Alexanderallenbrown/MotionBase/figures/MotionBase2.jpg

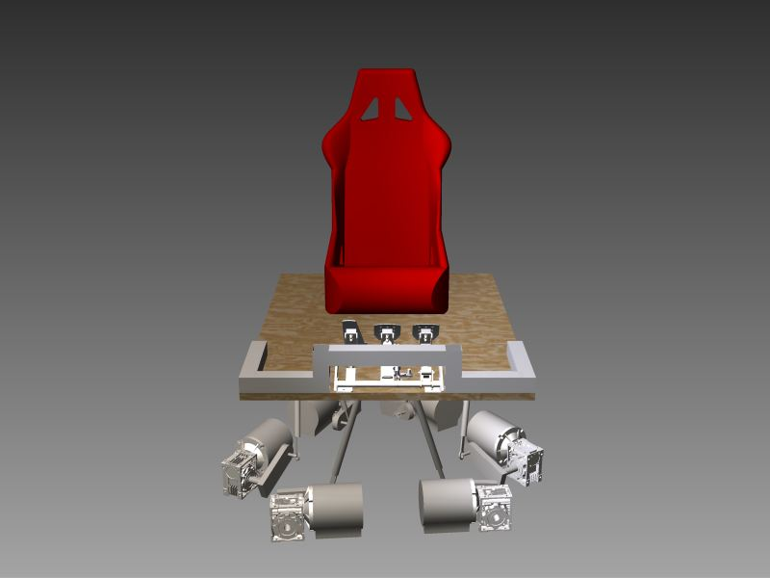
figures/MotionBase2.jpg
