Alexanderallenbrown/MotionBase/figures/20160426_115752.jpg

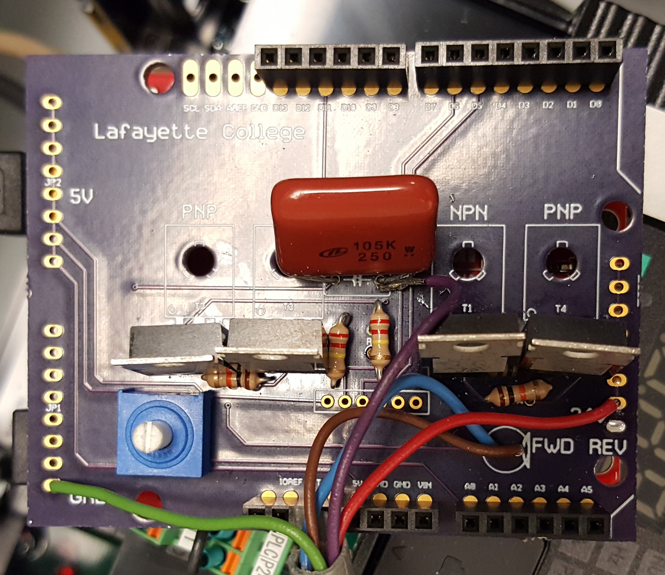
figures/20160426_115752.jpg
