Alexanderallenbrown/MotionBase/README.md

# MotionBase
An open-source motion platform for driving simulation

**For the wiki page documenting this project, please see the Wiki link above**
