Alexanderallenbrown/MotionBase/Board_Pictures/IMG_4478.JPG

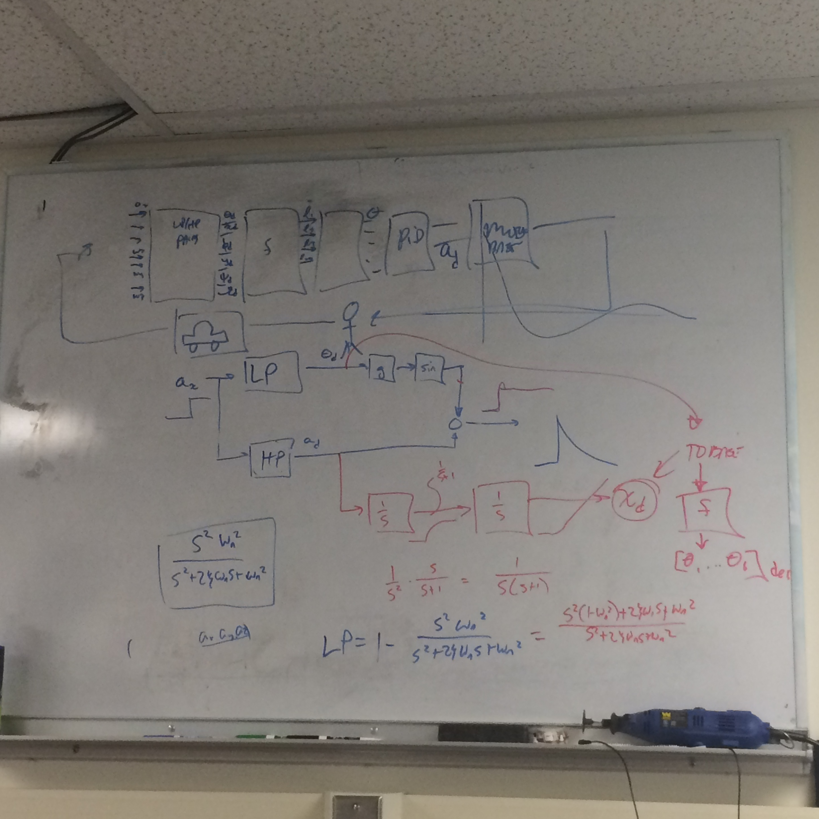
Board_Pictures/IMG_4478.JPG
