Alexanderallenbrown/MotionBase/Board_Pictures/IMG_4479.JPG

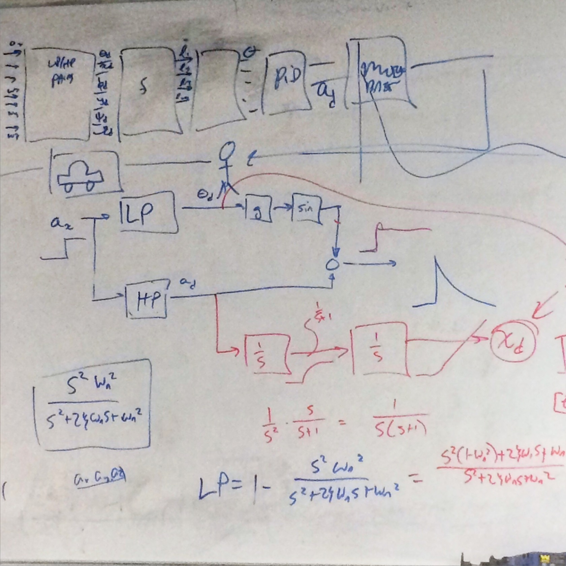
Board_Pictures/IMG_4479.JPG
