Alexanderallenbrown/MotionBase/Board_Pictures/IMG_4487.JPG

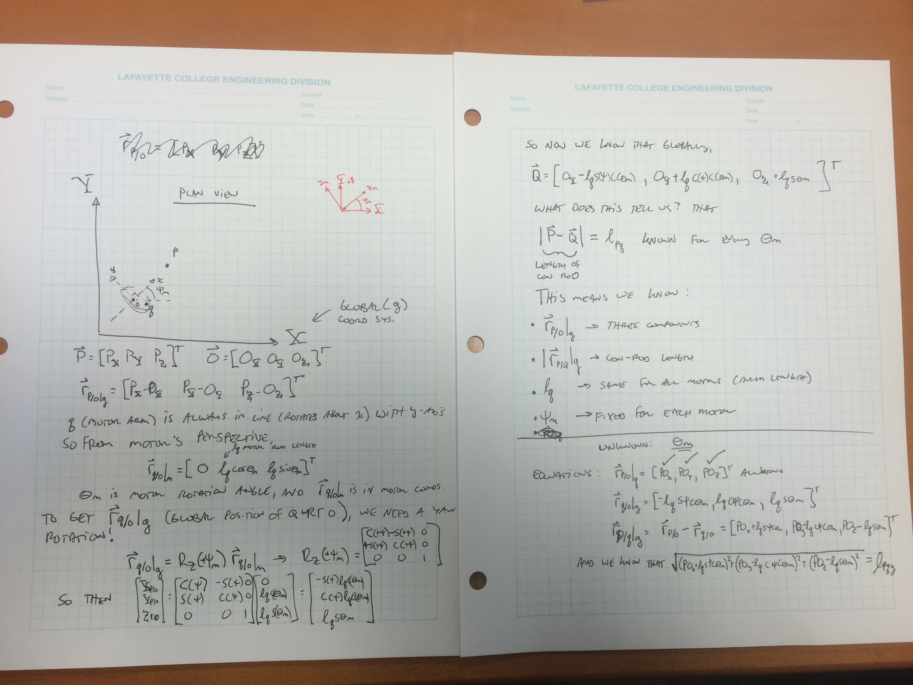
Board_Pictures/IMG_4487.JPG
