Alexanderallenbrown/MotionBase/Board_Pictures/IMG_4494.JPG

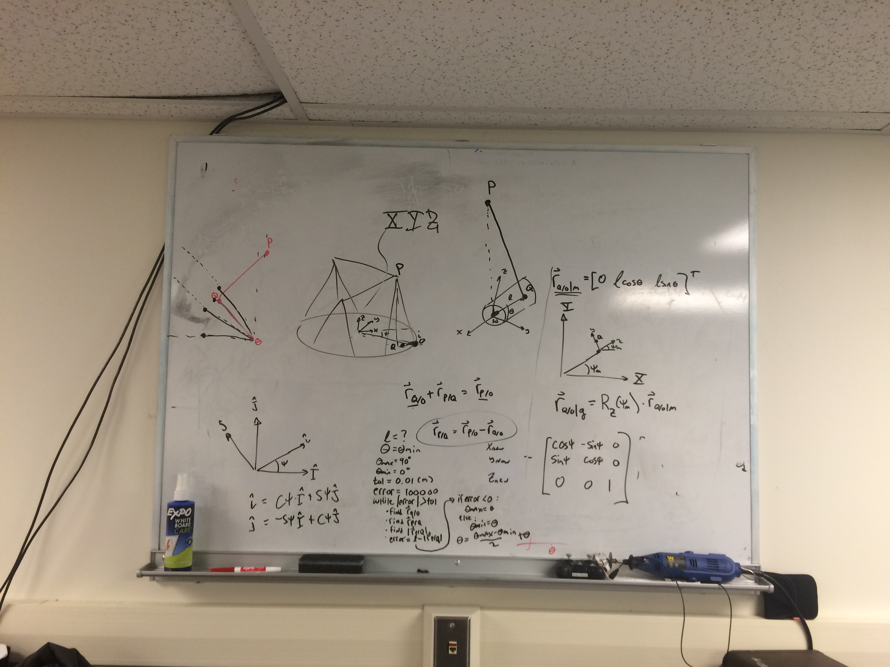
Board_Pictures/IMG_4494.JPG
