Alexanderallenbrown/MotionBase/Board_Pictures/IMG_4495.JPG

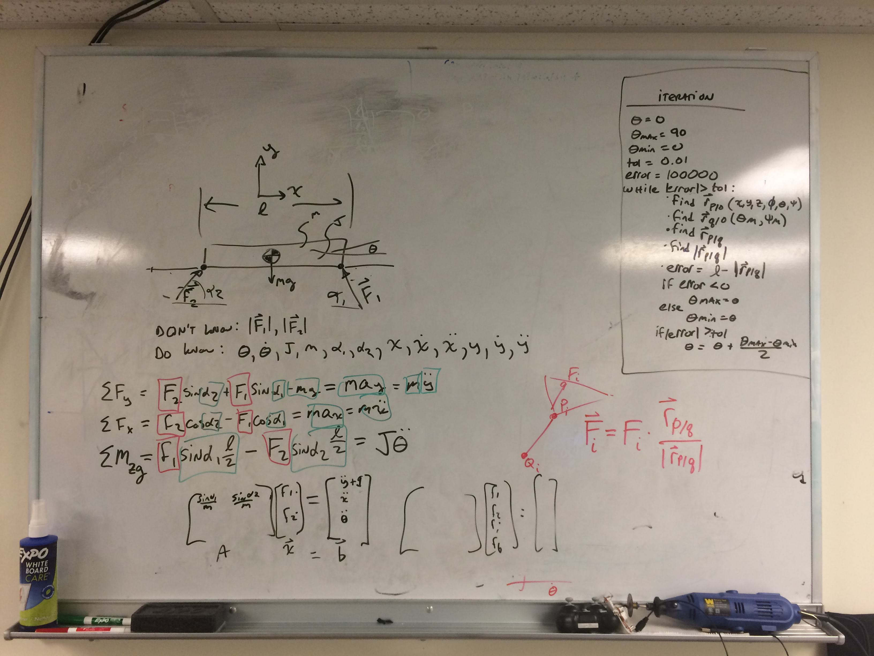
Board_Pictures/IMG_4495.JPG
