Alexanderallenbrown/MotionBase/figures/2525_1_.jpg

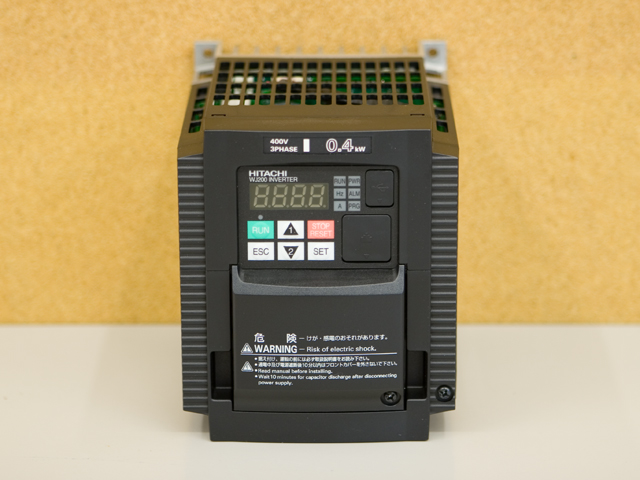
figures/2525_1_.jpg
