Alexanderallenbrown/MotionBase/figures/filtered t-w graph.png

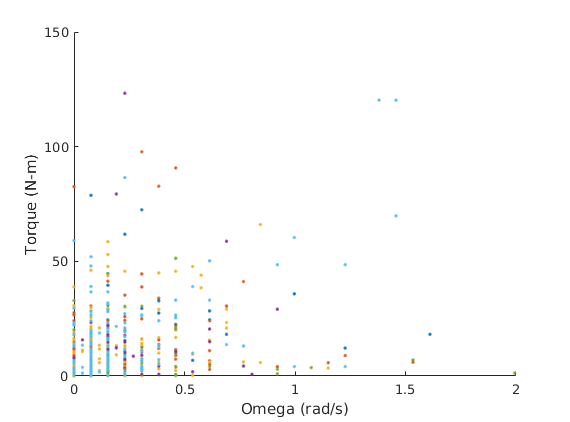
figures/filtered t-w graph.png
