Alexanderallenbrown/MotionBase/figures/helical_gear.jpg

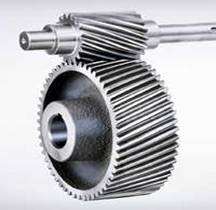
figures/helical_gear.jpg
