Alexanderallenbrown/MotionBase/figures/IMG_5075.jpg

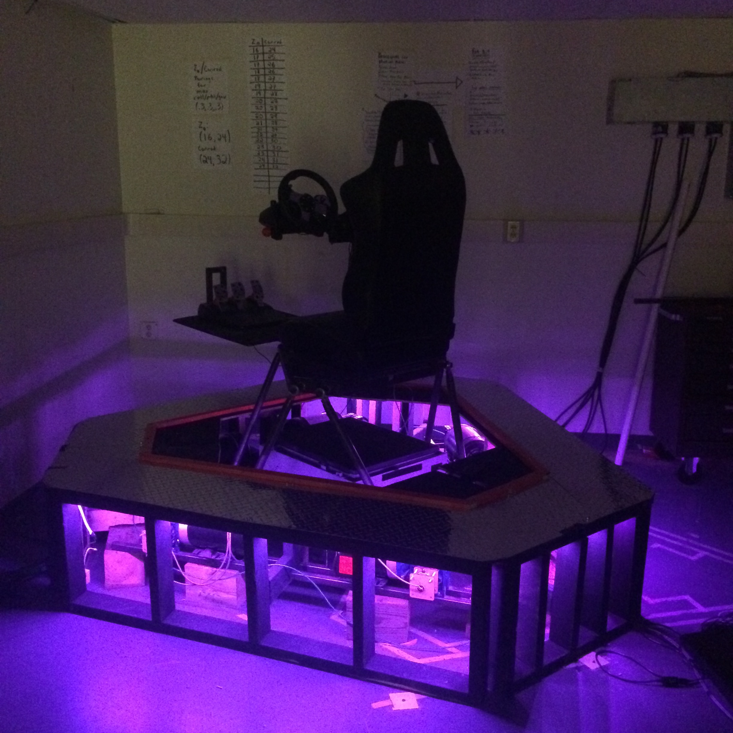
figures/IMG_5075.jpg
