Alexanderallenbrown/MotionBase/figures/m_tprs56cmtrs.jpg

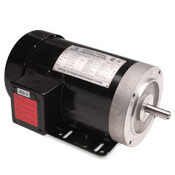
figures/m_tprs56cmtrs.jpg
