Alexanderallenbrown/MotionBase/figures/m_wga50m080h1.jpg

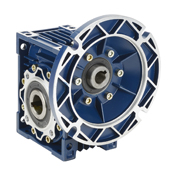
figures/m_wga50m080h1.jpg
