Alexanderallenbrown/MotionBase/figures/Mechatronics control diagram_v3.png

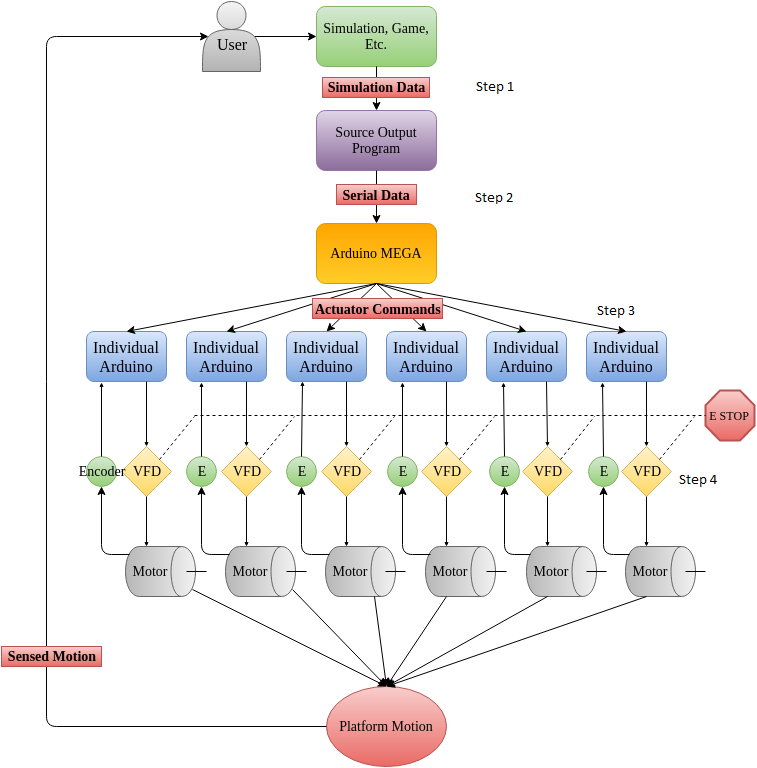
figures/Mechatronics control diagram_v3.png
