Alexanderallenbrown/MotionBase/figures/MotionBase1.jpg

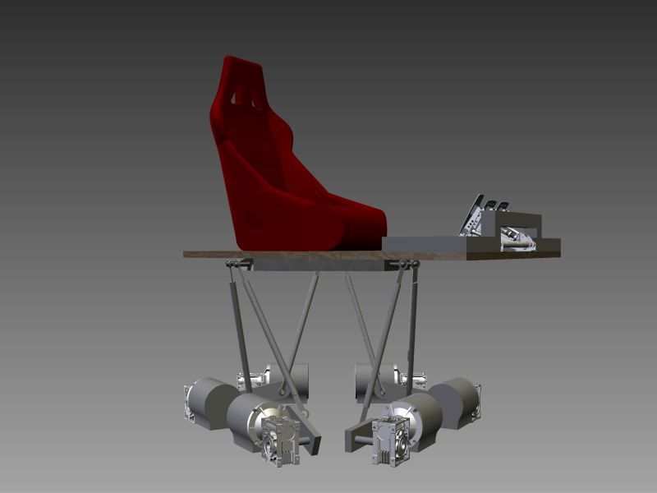
figures/MotionBase1.jpg
