Alexanderallenbrown/MotionBase/figures/MotionBaseNew2.jpg

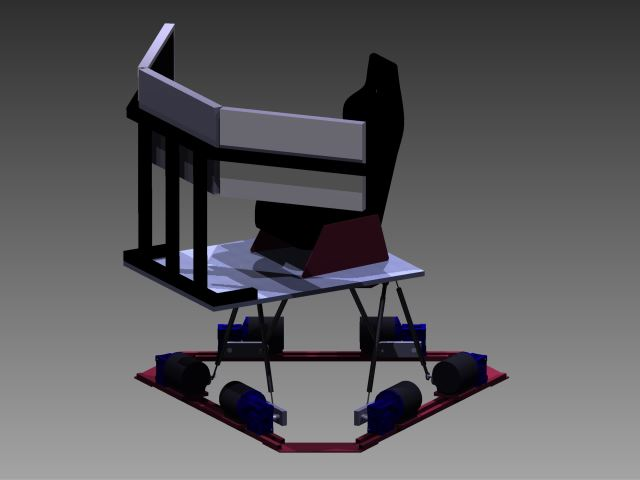
figures/MotionBaseNew2.jpg
