Alexanderallenbrown/MotionBase/figures/MotionBaseNew.jpg

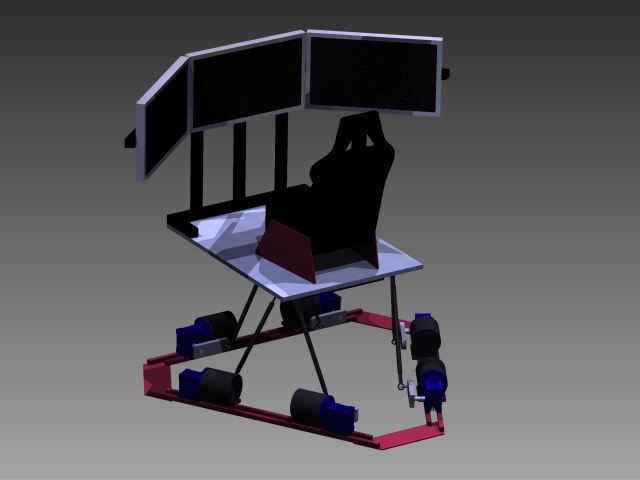
figures/MotionBaseNew.jpg
