Alexanderallenbrown/MotionBase/figures/motor bounds.png

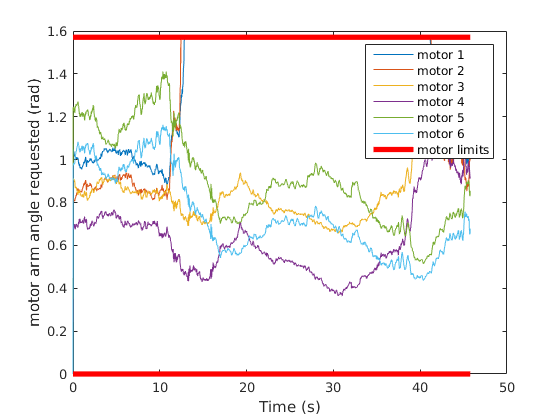
figures/motor bounds.png
