Alexanderallenbrown/MotionBase/figures/motor_angles.png

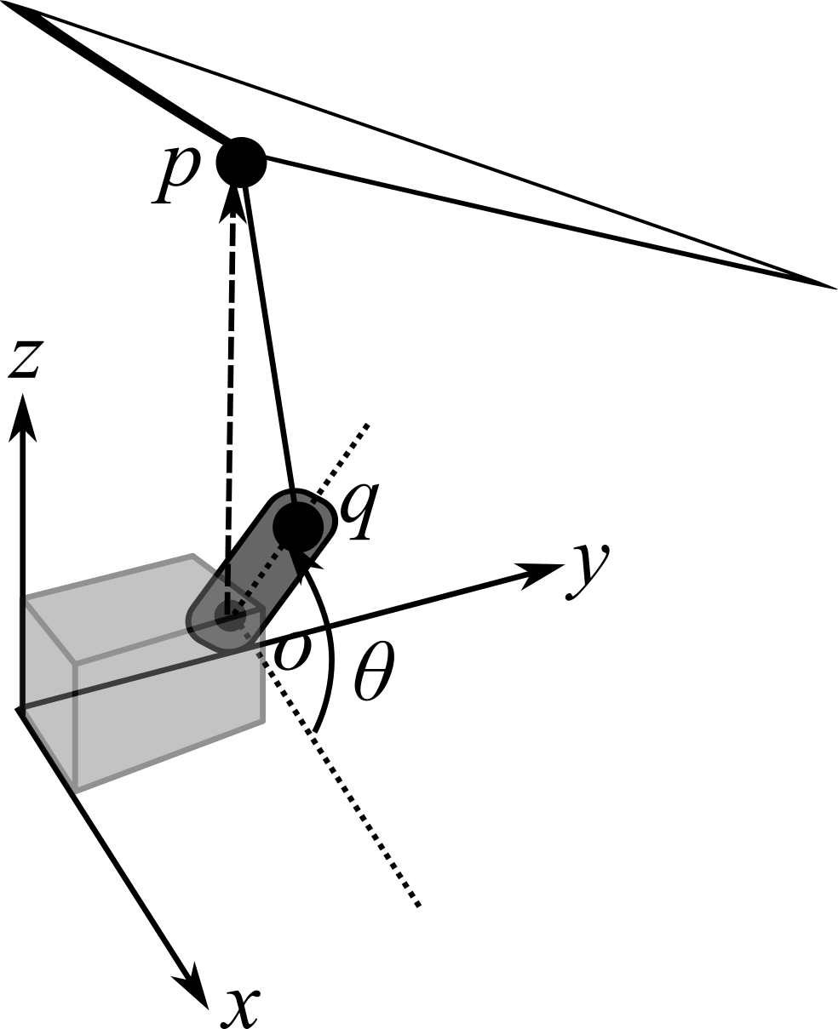
figures/motor_angles.png
