Alexanderallenbrown/MotionBase/figures/pwm_wave.png

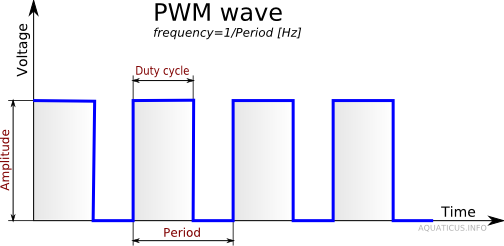
figures/pwm_wave.png
