Alexanderallenbrown/MotionBase/figures/Torque-Omega_Curve.jpg

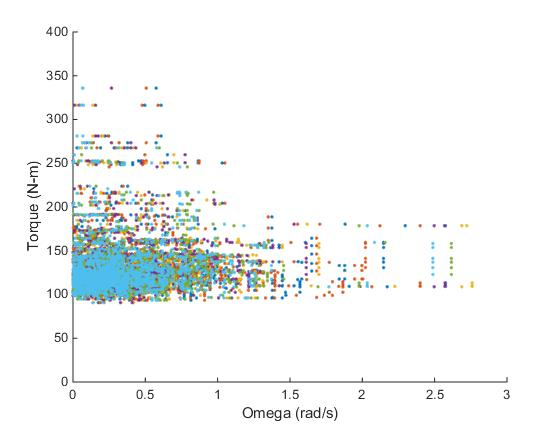
figures/Torque-Omega_Curve.jpg
