Alexanderallenbrown/MotionBase/figures/x_angley.jpg

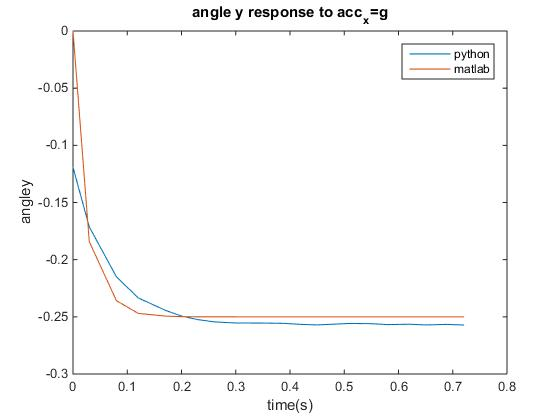
figures/x_angley.jpg
