Alexanderallenbrown/MotionBase/figures/x_xacc.jpg

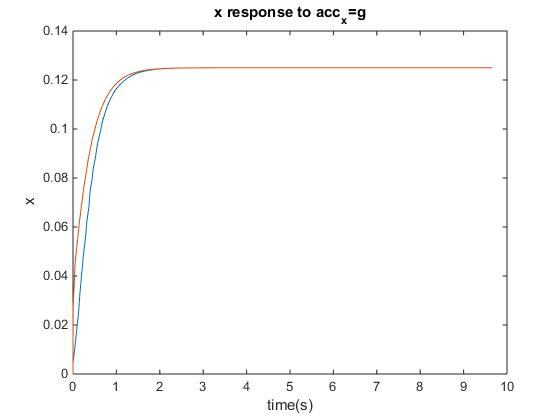
figures/x_xacc.jpg
