Alexanderallenbrown/MotionBase/figures/yaw_response.jpg

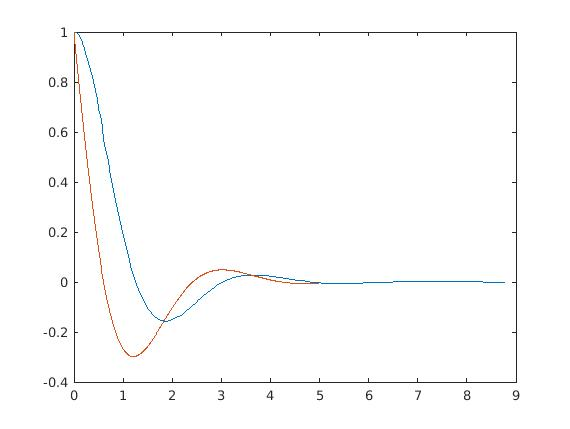
figures/yaw_response.jpg
