Alexanderallenbrown/MotionBase/figures/z_zacc.jpg

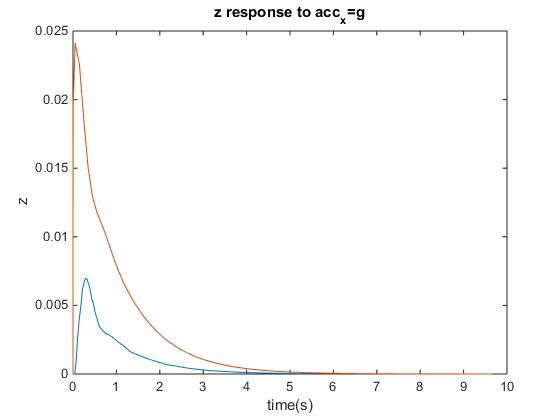
figures/z_zacc.jpg
