Alexanderallenbrown/MotionBase/mini_platform/board/board_v0_1.png

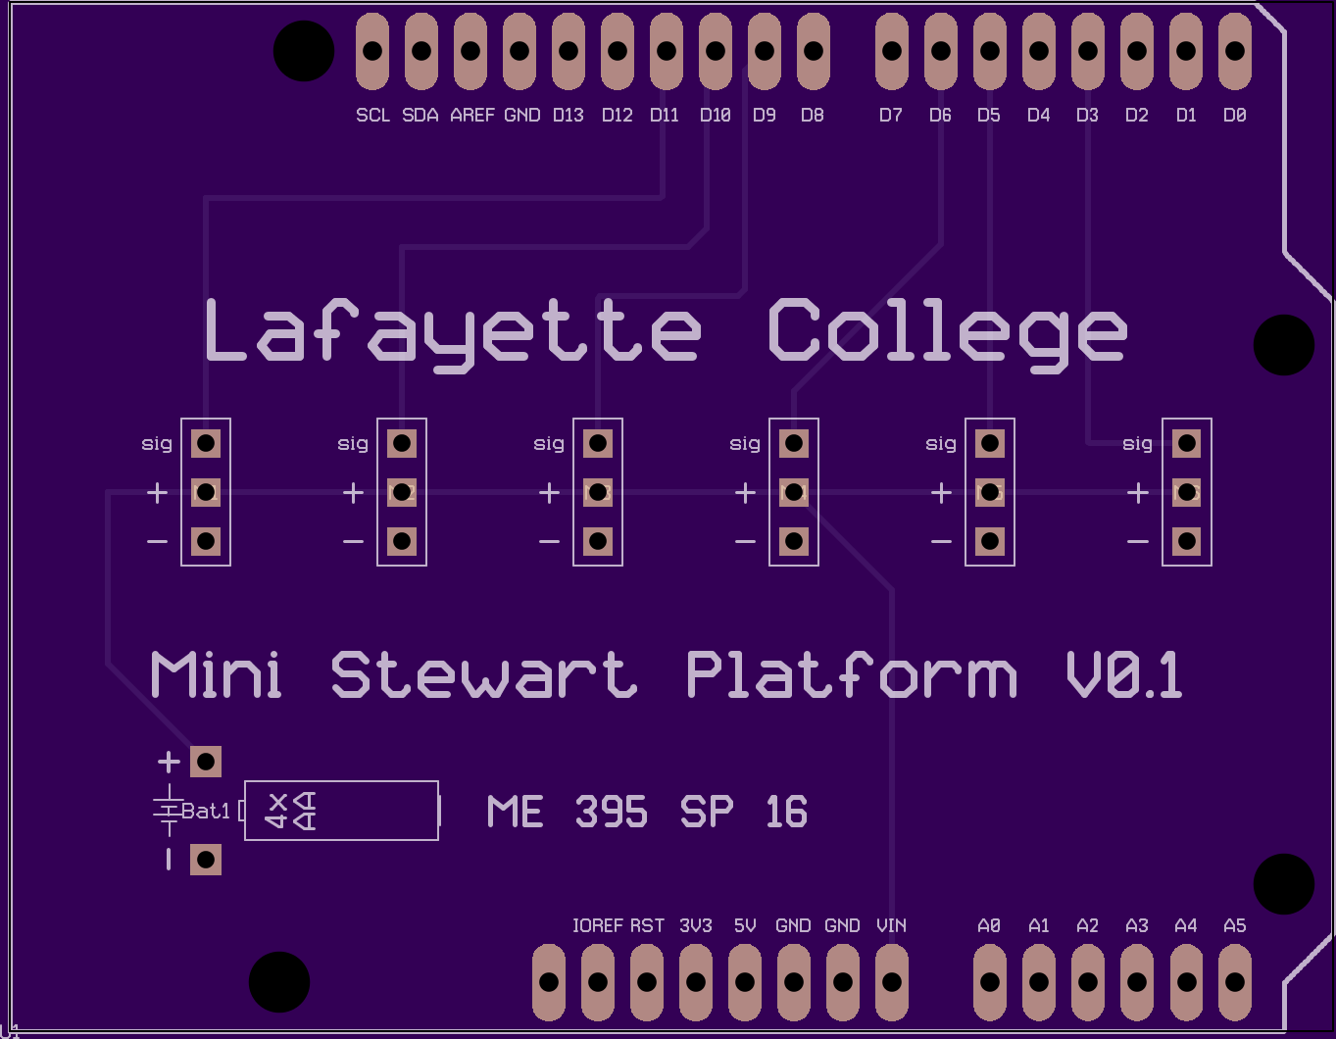
mini_platform/board/board_v0_1.png
