Alexanderallenbrown/MotionBase/python/controller_diagram.png

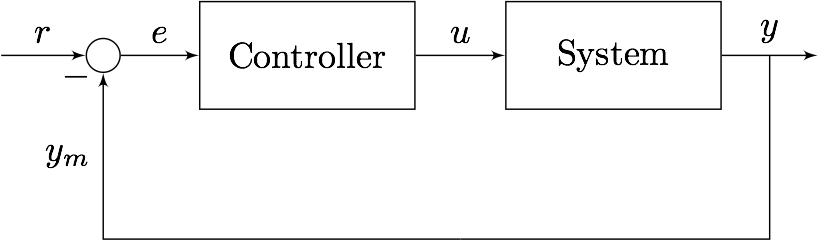
python/controller_diagram.png
