Alexanderallenbrown/MotionBase/python/lowpass_highpass-2.png

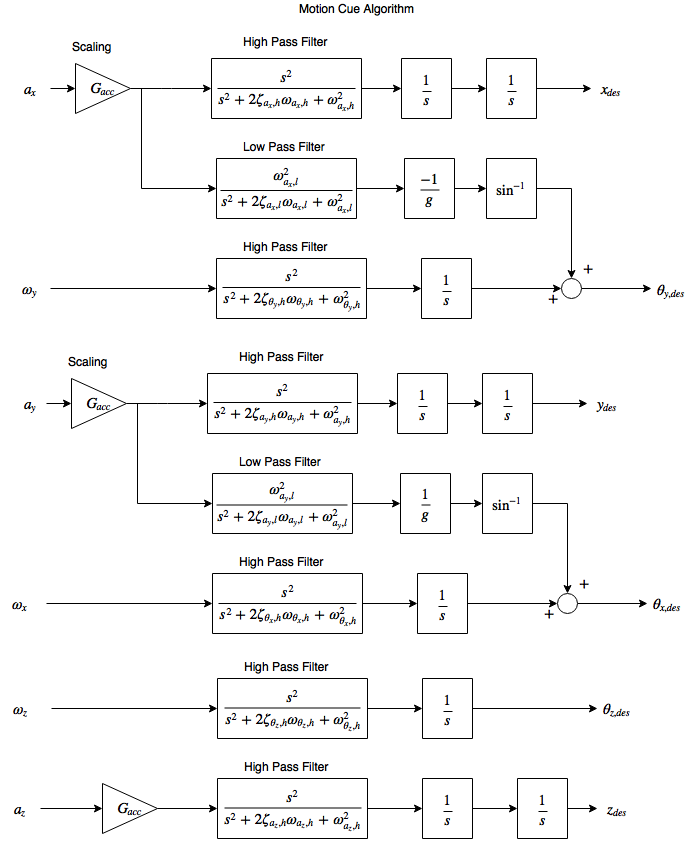
python/lowpass_highpass-2.png
