Alexanderallenbrown/MotionBase/CAD/MotionBaseCAD/Imported Components/TMDF 180L/TMDF 180L.htm

Autodesk Inventor Translation Report | Monday, February 22, 2016 ( 10:29 AM)
Source File: | C:\Users\jonesdm\Desktop\motionbase\CAD\MotionBaseCAD\TMDF 180L.SLDPRT
Translator Type: | SolidWorks | Sending System: | SolidWorks 2014
Author: |  | Translation Time: | 00:00:01
Options
Import Type: | N/A
Entity Types to Import: | Solids, Surfaces, Wires
Import into Repair Environment: | Yes
Import Assembly as Single Part: | No
Create Surfaces As: | Single Composite Feature
Check Parts during Load: | No
Auto Stitch: | No
Enable Advanced Healing: | N/A
+/- | Name | Inventor File | Status
[ ] | TMDF 180L.ipt | C:\Users\jonesdm\Desktop\motionbase\CAD\MotionBaseCAD\Imported Components\TMDF 180L\TMDF 180L.ipt | Successful
