Alexanderallenbrown/MotionBase/CAD/MotionBaseCAD/Imported Components/WGA-50M-080-H1/WGA-50M-080-H1.htm

Autodesk Inventor Translation Report | Wednesday, February 24, 2016 ( 9:17 AM)
Source File: | C:\Users\jonesdm\Desktop\MotionBase\CAD\MotionBaseCAD\WGA-50M-080-H1.STEP
Translator Type: | STEP | Sending System: | SolidWorks 2014
Author: |  | Translation Time: | 00:00:00
Options
Import Type: | N/A
Entity Types to Import: | Solids, Surfaces, Wires, Points
Import into Repair Environment: | Yes
Import Assembly as Single Part: | No
Create Surfaces As: | Single Composite Feature
Check Parts during Load: | No
Auto Stitch: | No
Enable Advanced Healing: | N/A
+/- | Name | Inventor File | Status
[ ] | WGA-50M-080-H1.ipt | C:\Users\jonesdm\Desktop\MotionBase\CAD\MotionBaseCAD\Imported Components\WGA-50M-080-H1\WGA-50M-080-H1.ipt | Successful
