Alexanderallenbrown/MotionBase/CAD/MotionBaseCAD/Real Platform/Imported Components/BallJoint/BallJoint.htm

Autodesk Inventor Translation Report | Thursday, April 7, 2016 ( 3:04 PM)
Source File: | C:\Users\Mac\Desktop\MotionBase\CAD\MotionBaseCAD\Real Platform\BallJoint.STEP
Translator Type: | STEP | Sending System: | SolidWorks 2012
Author: | Admin | Translation Time: | 00:00:17
Options
Import Type: | N/A
Entity Types to Import: | Solids, Surfaces, Wires, Points
Import into Repair Environment: | Yes
Import Assembly as Single Part: | No
Create Surfaces As: | Single Composite Feature
Check Parts during Load: | No
Auto Stitch: | No
Enable Advanced Healing: | N/A
+/- | Name | Inventor File | Status
[+] [-] | BallJoint | C:\Users\Mac\Desktop\MotionBase\CAD\MotionBaseCAD\Real Platform\Imported Components\BallJoint\BallJoint.ipt | Warning
Severity | Entity Id | Message
Warning | 2278 | Some Surfaces have been simplified
