Alexanderallenbrown/MotionBase/CAD/MotionBaseCAD/Real Platform/Imported Components/ThreadedCaps/ThreadedCaps.htm

Autodesk Inventor Translation Report | Thursday, April 7, 2016 ( 3:02 PM)
Source File: | C:\Users\Mac\Desktop\MotionBase\CAD\MotionBaseCAD\Real Platform\ThreadedCaps.STEP
Translator Type: | STEP | Sending System: | SolidWorks 2010
Author: |  | Translation Time: | 00:00:38
Options
Import Type: | N/A
Entity Types to Import: | Solids, Surfaces, Wires, Points
Import into Repair Environment: | Yes
Import Assembly as Single Part: | No
Create Surfaces As: | Single Composite Feature
Check Parts during Load: | No
Auto Stitch: | No
Enable Advanced Healing: | N/A
+/- | Name | Inventor File | Status
[ ] | ThreadedCaps | C:\Users\Mac\Desktop\MotionBase\CAD\MotionBaseCAD\Real Platform\Imported Components\ThreadedCaps\ThreadedCaps.ipt | Successful
