Alexanderallenbrown/MotionBase/Bill of Materials/BaseTriangle.xlsx

Senior Design - PURCHASE REQUEST FORM
Project Name: |  | ME395
STUDENT Information
Name: |  | Mac Jones
Supervisor |  | Alex Brown
Contact E-Mail: |  | jonesdm@lafayette.edu
Account to Charge:
VENDOR Information
Date: | 2016-04-11 |  |  |  | Web/email address: | mcmaster.com
Vendor Name: |  | McMaster
Address:
City: |  |  |  | State: |  | Zip Code:
Phone:
Fax:
# | Qty | Unit | Part # | Description |  |  | Unit Price | Price
1 | 6 | PCS | 6527K364 (http://www.mcmaster.com/) | Low-Carbon Steel Square Tube 1" Wide, 1" High, .120" Wall Thickness, 6 ft. length |  |  | $24.14 | $144.84
2 | 1 | PCS | 6544K67 (http://www.mcmaster.com/) | Low-Carbon Steel Sheet 0.120" Thick, 24" x 24" |  |  | $61.54 | $61.54
3 | 1 | PKG | 97083A330 (http://www.mcmaster.com/) | Internally Threaded Anchor for Concrete Zinc-Plated Steel, 1/2"-13 Screw Size, 2" Length |  |  | $13.14 | $13.14
4 | 1 | PKG | 92865A720 (http://www.mcmaster.com/) | Medium-Strength Grade 5 Zinc-Plated Steel Cap Screw 1/2"-13 Fully Threaded, 2" Long |  |  | $7.85 | $7.85
5 | 1 | PCS | 8975K102 (http://www.mcmaster.com/) | Multipurpose 6061 Aluminum 1" Thick x 10" Width, 3ft. Length |  |  | $186.71 | $186.71
6 |  |  |  |  |  |  |  | $0.00
7 |  |  |  |  |  |  |  | $0.00
8 |  |  |  |  |  |  |  | $0.00
9 |  |  |  |  |  |  |  | $0.00
10 |  |  |  |  |  |  |  | $0.00
11 |  |  |  |  |  |  |  | $0.00
12 |  |  |  |  |  |  |  | $0.00
13 |  |  |  |  |  |  |  | $0.00
14 |  |  |  |  |  |  |  | $0.00
15 |  |  |  |  |  |  |  | $0.00
16 |  |  |  |  |  |  |  | $0.00
17 |  |  |  |  |  |  |  | $0.00
18 |  |  |  |  |  |  |  | $0.00
19 |  |  |  |  |  |  |  | $0.00
20 |  |  |  |  |  |  |  | $0.00
Total |  |  |  |  |  |  |  | $414.08
Advisor Signature:
 |  |  |  | Alexander Brown
Comments/Special Instructions:
