Alexanderallenbrown/MotionBase/Bill of Materials/Digikey.xlsx

Senior Design - PURCHASE REQUEST FORM
Project Name: |  | ME395
STUDENT Information
Name: |  | Mac Jones
Supervisor |  | Alex Brown
Contact E-Mail: |  | jonesdm@lafayette.edu
Account to Charge:
VENDOR Information
Date: | 2016-04-14 |  |  |  | Web/email address: | digikey.com
Vendor Name: |  | Digikey
Address:
City: |  |  |  | State: |  | Zip Code:
Phone:
Fax:
# | Qty | Unit | Part # | Description |  |  | Unit Price | Price
1 | 10 | PCS | BC33825TACT-ND (https://www.digikey.com/product-detail/en/fairchild-semiconductor/BC33825TA/BC33825TACT-ND/4213833) | TRANS NPN 25V 0.8A TO-92 |  |  | $0.20 | $1.96
2 | 10 | PCS | SS8550BBUFS-ND (https://www.digikey.com/product-detail/en/fairchild-semiconductor/SS8550BBU/SS8550BBUFS-ND/1047357) | TRANS PNP 25V 1.5A TO-92 |  |  | $0.20 | $1.96
3 | 10 | PCS | 445-8517-ND (https://www.digikey.com/product-detail/en/tdk-corporation/FK24X7R1H105K/445-8517-ND/2815447) | 1µF ±10% 50V X7R Ceramic Capacitor -55°C ~ 125°C Through Hole Radial 0.177" L x 0.098" W (4.50mm x 2.50mm) |  |  | $0.28 | $2.78
4 | 30 | PCS | CF14JT10K0CT-ND (https://www.digikey.com/product-detail/en/stackpole-electronics-inc/CF14JT10K0/CF14JT10K0CT-ND/1830374) | 10k Ohm ±5% 0.25W, 1/4W Surface Mount Resistor Carbon Film 0/ -500ppm/°C Axial |  |  | $0.04 | $1.20
5 | 10 | PCS | CF12JT220KCT-ND (https://www.digikey.com/product-detail/en/stackpole-electronics-inc/CF12JT220K/CF12JT220KCT-ND/1830532) | 220k Ohm ±5% 0.5W, 1/2W Surface Mount Resistor Carbon Film 0/ -850ppm/°C Axial |  |  | $0.07 | $0.72
6 | 6 | PCS | 3310Y-025-103L-ND (https://www.digikey.com/product-detail/en/bourns-inc/3310Y-025-103L/3310Y-025-103L-ND/2534071) | POT 10K OHM 1/4W PLASTIC LINEAR |  |  | $3.65 | $21.90
7 |  |  |  |  |  |  |  | $0.00
8 |  |  |  |  |  |  |  | $0.00
9 |  |  |  |  |  |  |  | $0.00
10 |  |  |  |  |  |  |  | $0.00
11 |  |  |  |  |  |  |  | $0.00
12 |  |  |  |  |  |  |  | $0.00
13 |  |  |  |  |  |  |  | $0.00
14 |  |  |  |  |  |  |  | $0.00
15 |  |  |  |  |  |  |  | $0.00
16 |  |  |  |  |  |  |  | $0.00
17 |  |  |  |  |  |  |  | $0.00
18 |  |  |  |  |  |  |  | $0.00
19 |  |  |  |  |  |  |  | $0.00
20 |  |  |  |  |  |  |  | $0.00
Total |  |  |  |  |  |  |  | $30.52
Advisor Signature:
 |  |  |  | Alexander Brown
Comments/Special Instructions:
