Alexanderallenbrown/MotionBase/Bill of Materials/Digikey_4-23.xlsx

Senior Design - PURCHASE REQUEST FORM
Project Name: |  | ME 395 Motionbase
STUDENT Information
Name: |  | Dallis Guillemin
Supervisor |  | Alexander Brown
Contact E-Mail: |  | guillemd@lafayette.edu
VENDOR Information
Date: | 2016-04-23 |  |  |  | Web/email address: | www.digikey.com
Vendor Name: |  | Digikey
Address: |  | 701 Brooks Ave South
City: |  | Thief River Falls |  | State: | MN | Zip Code: | 56701
Phone: |  | 1-800-344-4539
Fax: |  | 218-681-3380
# | Qty | Unit | Part # | Description |  |  | Unit Price | Price
1 | 1 | 1 | C0753AG-100-ND | Shielded wire, 24 AWG, 100' |  |  | $63.86 | $63.86
2 | 10 | 1 | TIP42C-ND | Transistor, PNP 100V 6A TO-220 |  |  | $0.53 | $5.31
3 | 10 | 1 | TIP41C-ND | Transistor, NPN 100V 6A TO-220 |  |  | $0.53 | $5.32
4 | 6 | 1 | 1568-1051-ND | Sparkfun Electronics ATMEGA328 |  |  | $19.95 | $119.70
5 | 1 | 1 | 1050-1018-ND | Arduino board MCU MEGA2560 |  |  | $51.91 | $51.91
6 | 8 | 1 | 1528-1074-ND | Stacking header ardunio sheild |  |  | $1.95 | $15.60
7 |  |  |  |  |  |  |  | $0.00
8 |  |  |  |  |  |  |  | $0.00
9 |  |  |  |  |  |  |  | $0.00
10 |  |  |  |  |  |  |  | $0.00
11 |  |  |  |  |  |  |  | $0.00
12 |  |  |  |  |  |  |  | $0.00
13 |  |  |  |  |  |  |  | $0.00
14 |  |  |  |  |  |  |  | $0.00
15 |  |  |  |  |  |  |  | $0.00
16 |  |  |  |  |  |  |  | $0.00
17 |  |  |  |  |  |  |  | $0.00
18 |  |  |  |  |  |  |  | $0.00
19 |  |  |  |  |  |  |  | $0.00
20 |  |  |  |  |  |  |  | $0.00
Total |  |  |  |  |  |  |  | $261.70
Advisor Signature:
 |  |  |  | Alexander Brown
Comments/Special Instructions:
