Alexanderallenbrown/MotionBase/Bill of Materials/Sparkfun-Arduinos.xlsx

Senior Design - PURCHASE REQUEST FORM
Project Name: |  | ME395
STUDENT Information
Name: |  | Mac Jones
Supervisor |  | Alex Brown
Contact E-Mail: |  | jonesdm@lafayette.edu
Account to Charge:
VENDOR Information
Date: | 2016-04-18 |  |  |  | Web/email address: | sparkfun.com
Vendor Name: |  | Sparkfun
Address:
City: |  |  |  | State: |  | Zip Code:
Phone:
Fax:
# | Qty | Unit | Part # | Description |  |  | Unit Price | Price
1 | 6 | PCS | DEV-12757 (https://www.sparkfun.com/products/12757) | SparkFun RedBoard - Programmed with Arduino |  |  | $19.95 | $119.70
2 | 12 | PCS | PRT-11417 (https://www.sparkfun.com/products/11417) | Arduino Stackable Header Kit - R3 |  |  | $1.50 | $18.00
3 | 1 | PCS | DEV-11061 (https://www.sparkfun.com/products/11061) | Arduino Mega 2560 R3 |  |  | $45.95 | $45.95
4 |  |  |  |  |  |  |  | $0.00
5 |  |  |  |  |  |  |  | $0.00
6 |  |  |  |  |  |  |  | $0.00
7 |  |  |  |  |  |  |  | $0.00
8 |  |  |  |  |  |  |  | $0.00
9 |  |  |  |  |  |  |  | $0.00
10 |  |  |  |  |  |  |  | $0.00
11 |  |  |  |  |  |  |  | $0.00
12 |  |  |  |  |  |  |  | $0.00
13 |  |  |  |  |  |  |  | $0.00
14 |  |  |  |  |  |  |  | $0.00
15 |  |  |  |  |  |  |  | $0.00
16 |  |  |  |  |  |  |  | $0.00
17 |  |  |  |  |  |  |  | $0.00
18 |  |  |  |  |  |  |  | $0.00
19 |  |  |  |  |  |  |  | $0.00
20 |  |  |  |  |  |  |  | $0.00
Total |  |  |  |  |  |  |  | $183.65
Advisor Signature:
 |  |  |  | Alexander Brown
Comments/Special Instructions:
