Alexanderallenbrown/MotionBase/Bill of Materials/TopTriangle.xlsx

Senior Design - PURCHASE REQUEST FORM
Project Name: |  | ME395
STUDENT Information
Name: |  | Mac Jones
Supervisor |  | Alex Brown
Contact E-Mail: |  | jonesdm@lafayette.edu
Account to Charge:
VENDOR Information
Date: | 2016-04-11 |  |  |  | Web/email address: | mcmaster.com
Vendor Name: |  | McMaster
Address:
City: |  |  |  | State: |  | Zip Code:
Phone:
Fax:
# | Qty | Unit | Part # | Description |  |  | Unit Price | Price
1 | 2 | PCS | 6566K56 (http://www.mcmaster.com/) | Easy-to-Weld 4130 Alloy Steel Rectangular Tube, .065" Thick Wall, 1" x 2" 6ft. Length |  |  | $123.52 | $247.04
2 | 1 | PCS | 6673T27 (http://www.mcmaster.com/) | Easy-to-Weld 4130 Alloy Rod, 1" Dia. 3ft Length |  |  | $39.68 | $39.68
3 | 12 | PCS | 91259A804 (http://www.mcmaster.com/) | Alloy Steel Shoulder Screw 5/8" Dia X 2-1/2" Long Shoulder, 1/2"-13 Thread |  |  | $3.90 | $46.80
4 |  |  |  |  |  |  |  | $0.00
5 |  |  |  |  |  |  |  | $0.00
6 |  |  |  |  |  |  |  | $0.00
7 |  |  |  |  |  |  |  | $0.00
8 |  |  |  |  |  |  |  | $0.00
9 |  |  |  |  |  |  |  | $0.00
10 |  |  |  |  |  |  |  | $0.00
11 |  |  |  |  |  |  |  | $0.00
12 |  |  |  |  |  |  |  | $0.00
13 |  |  |  |  |  |  |  | $0.00
14 |  |  |  |  |  |  |  | $0.00
15 |  |  |  |  |  |  |  | $0.00
16 |  |  |  |  |  |  |  | $0.00
17 |  |  |  |  |  |  |  | $0.00
18 |  |  |  |  |  |  |  | $0.00
19 |  |  |  |  |  |  |  | $0.00
20 |  |  |  |  |  |  |  | $0.00
Total |  |  |  |  |  |  |  | $333.52
Advisor Signature:
 |  |  |  | Alexander Brown
Comments/Special Instructions:
