Alexanderallenbrown/MotionBase/Bill of Materials/ConRods.xlsx

Senior Design - PURCHASE REQUEST FORM
Project Name: |  | ME395
STUDENT Information
Name: |  | Mac Jones
Supervisor |  | Alex Brown
Contact E-Mail: |  | jonesdm@lafayette.edu
Account to Charge:
VENDOR Information
Date: | 2016-04-10 |  |  |  | Web/email address: | mcmaster.com
Vendor Name: |  | McMaster
Address:
City: |  |  |  | State: |  | Zip Code:
Phone:
Fax:
# | Qty | Unit | Part # | Description |  |  | Unit Price | Price
1 | 6 | PCS | 60645K171 (http://www.mcmaster.com/) | Steel Ball Joint Rod End 5/8"-18 RH Male Shank, 5/8" Ball ID, 1-5/8" Long Thread |  |  | $9.94 | $59.64
2 | 6 | PCS | 60645K172 (http://www.mcmaster.com/) | Steel Ball Joint Rod End 5/8"-18 Left-Hand Male Shank, 5/8" Ball ID, 1-5/8" Long Thread |  |  | $9.94 | $59.64
3 | 6 | PCS | 94640A360 (http://www.mcmaster.com/) | Tube-End Weld Nut Right-Hand Threaded, for 1-1/4" Tube OD, 0.12" Thick Wall, 5/8"-18 |  |  | $6.12 | $36.72
4 | 6 | PCS | 94640A364 (http://www.mcmaster.com/) | Tube-End Weld Nut Left-Hand Threaded, for 1-1/4" Tube OD, 0.12" Thick Wall, 5/8"-18 |  |  | $6.12 | $36.72
5 | 2 | PCS | 89955K969 (http://www.mcmaster.com/) | Easy-to-Weld 4130 Alloy Steel Round Tube 1.25" OD, .12" Wall Thickness, 6ft length |  |  | $78.13 | $156.26
6 |  |  |  |  |  |  |  | $0.00
7 |  |  |  |  |  |  |  | $0.00
8 |  |  |  |  |  |  |  | $0.00
9 |  |  |  |  |  |  |  | $0.00
10 |  |  |  |  |  |  |  | $0.00
11 |  |  |  |  |  |  |  | $0.00
12 |  |  |  |  |  |  |  | $0.00
13 |  |  |  |  |  |  |  | $0.00
14 |  |  |  |  |  |  |  | $0.00
15 |  |  |  |  |  |  |  | $0.00
16 |  |  |  |  |  |  |  | $0.00
17 |  |  |  |  |  |  |  | $0.00
18 |  |  |  |  |  |  |  | $0.00
19 |  |  |  |  |  |  |  | $0.00
20 |  |  |  |  |  |  |  | $0.00
Total |  |  |  |  |  |  |  | $348.98
Advisor Signature:
 |  |  |  | Alexander Brown
Comments/Special Instructions:
