Alexanderallenbrown/MotionBase/CAD/Motion Base Rough model/Imported Components/siege/siege.htm

Autodesk Inventor Translation Report | Tuesday, February 02, 2016 ( 10:31 PM)
Source File: | U:\Mechatronics\Motion Base Rough model\siege.SLDPRT
Translator Type: | SolidWorks | Sending System: | SolidWorks 2011
Author: |  | Translation Time: | 00:00:03
Options
Import Type: | N/A
Entity Types to Import: | Solids, Surfaces, Wires
Import into Repair Environment: | Yes
Import Assembly as Single Part: | No
Create Surfaces As: | Single Composite Feature
Check Parts during Load: | No
Auto Stitch: | No
Enable Advanced Healing: | N/A
+/- | Name | Inventor File | Status
[+] [-] | siege.ipt | U:\Mechatronics\Motion Base Rough model\Imported Components\siege\siege.ipt | Warning
Severity | Entity Id | Message
Warning | 5852 | Degenerate Surface Detected - Please Run the Quality Check Tool
Warning | 100 | Some Surfaces have been simplified
