Alexanderallenbrown/MotionBase/CAD/Motion Base Rough model/Imported Components/Sparco Volante wheel/Sparco Volante wheel.htm

Autodesk Inventor Translation Report | Tuesday, February 02, 2016 ( 10:01 PM)
Source File: | U:\Mechatronics\Motion Base Rough model\Sparco Volante wheel.IGS
Translator Type: | IGES | Sending System: | SolidWorks 2009
Author: | Jay | Translation Time: | 00:00:05
Options
Import Type: | N/A
Entity Types to Import: | Solids, Surfaces, Wires, Points
Import into Repair Environment: | Yes
Import Assembly as Single Part: | No
Create Surfaces As: | Single Composite Feature
Check Parts during Load: | No
Auto Stitch: | No
Enable Advanced Healing: | N/A
+/- | Name | Inventor File | Status
[+] [-] | Sparco Volante wheel.ipt | U:\Mechatronics\Motion Base Rough model\Imported Components\Sparco Volante wheel\Sparco Volante wheel.ipt | Warning
Severity | Entity Id | Message
Warning | 3 | Some Surfaces have been simplified
Warning | 9 | Some Surfaces have been simplified
Warning | 11 | Some Surfaces have been simplified
Warning | 13 | Some Surfaces have been simplified
Warning | 19 | Some Surfaces have been simplified
Warning | 20 | Some Surfaces have been simplified
Warning | 21 | Some Surfaces have been simplified
Warning | 22 | Some Surfaces have been simplified
Warning | 23 | Some Surfaces have been simplified
Warning | 24 | Some Surfaces have been simplified
Warning | 25 | Some Surfaces have been simplified
Warning | 26 | Some Surfaces have been simplified
Warning | 27 | Some Surfaces have been simplified
Warning | 28 | Some Surfaces have been simplified
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
Warning | 403 | Some Surfaces have been simplified
Warning | 404 | Some Surfaces have been simplified
Warning | 405 | Some Surfaces have been simplified
Warning | 407 | Some Surfaces have been simplified
Warning | 408 | Some Surfaces have been simplified
Warning | 409 | Some Surfaces have been simplified
Warning | 412 | Some Surfaces have been simplified
Warning | 413 | Some Surfaces have been simplified
Warning | 414 | Some Surfaces have been simplified
Warning | 416 | Some Surfaces have been simplified
Warning | 417 | Some Surfaces have been simplified
Warning | 418 | Some Surfaces have been simplified
Warning | 420 | Some Surfaces have been simplified
Warning | 421 | Some Surfaces have been simplified
Warning | 422 | Some Surfaces have been simplified
Warning | 423 | Some Surfaces have been simplified
Warning | 426 | Some Surfaces have been simplified
Warning | 427 | Some Surfaces have been simplified
Warning | 428 | Some Surfaces have been simplified
