Alexanderallenbrown/MotionBase/Bill of Materials/McMaster_4-23.xlsx

Senior Design - PURCHASE REQUEST FORM
Project Name: |  | ME 395 Motionbase
STUDENT Information
Name: |  | Dallis Guillemin
Supervisor |  | Alexander Brown
Contact E-Mail: |  | guillemd@lafayette.edu
VENDOR Information
Date: | 2016-04-23 |  |  |  | Web/email address:
Vendor Name:
Address:
City: |  |  |  | State: | PA | Zip Code:
Phone:
Fax:
# | Qty | Unit | Part # | Description |  |  | Unit Price | Price
1 |  |  |  |  |  |  |  | $0.00
2 |  |  |  |  |  |  |  | $0.00
3 |  |  |  |  |  |  |  | $0.00
4 |  |  |  |  |  |  |  | $0.00
5 |  |  |  |  |  |  |  | $0.00
6 |  |  |  |  |  |  |  | $0.00
7 |  |  |  |  |  |  |  | $0.00
8 |  |  |  |  |  |  |  | $0.00
9 |  |  |  |  |  |  |  | $0.00
10 |  |  |  |  |  |  |  | $0.00
11 |  |  |  |  |  |  |  | $0.00
12 |  |  |  |  |  |  |  | $0.00
13 |  |  |  |  |  |  |  | $0.00
14 |  |  |  |  |  |  |  | $0.00
15 |  |  |  |  |  |  |  | $0.00
16 |  |  |  |  |  |  |  | $0.00
17 |  |  |  |  |  |  |  | $0.00
18 |  |  |  |  |  |  |  | $0.00
19 |  |  |  |  |  |  |  | $0.00
20 |  |  |  |  |  |  |  | $0.00
Total |  |  |  |  |  |  |  | $0.00
Advisor Signature:
 |  |  |  | Alexander Brown
Comments/Special Instructions:
Order needs to be placed by call for tax exemption. Have the foam shipped, the building is no longer in Easton.
