Alexanderallenbrown/MotionBase/CAD/Motion Base Rough model/siege.SLDPRT

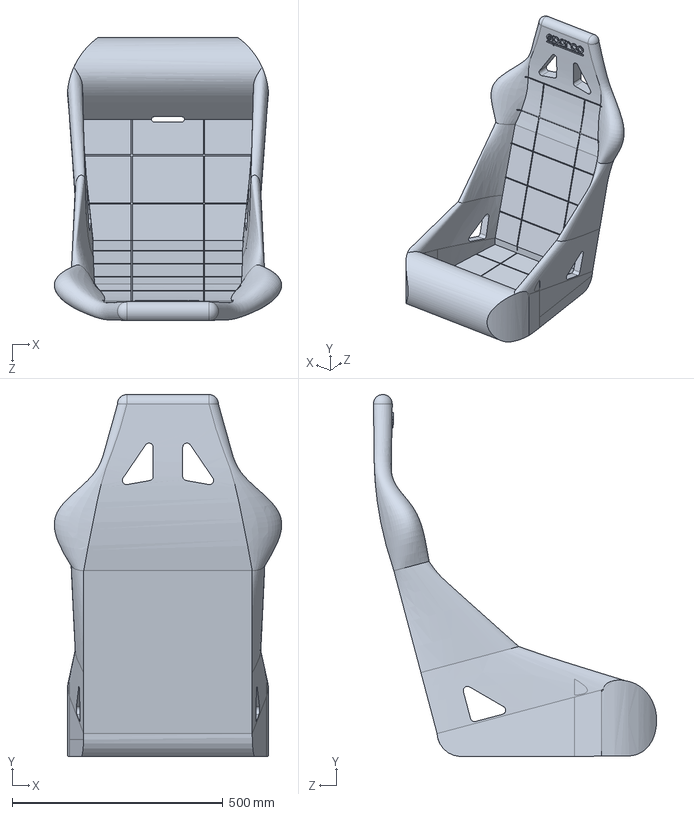
[picture p62: CAD file, 2016-02-03]
CAD/Motion Base Rough model/siege.SLDPRT
539.7 x 859.5 x 672.6 mm
