Alexanderallenbrown/MotionBase/CAD/MotionBaseCAD/ControllerMount/SharpCap.stl

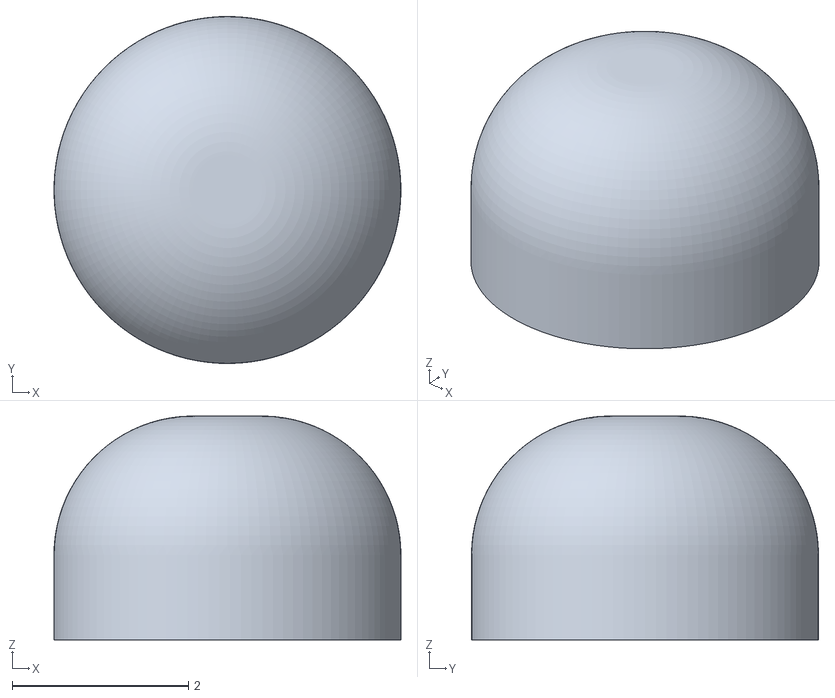
[picture p63: CAD file, 2016-08-09]
CAD/MotionBaseCAD/ControllerMount/SharpCap.stl
3.94 x 3.94 x 2.54
