Alexanderallenbrown/MotionBase/CAD/MotionBaseCAD/Real Platform/Drawings/Triangle End2.dxf

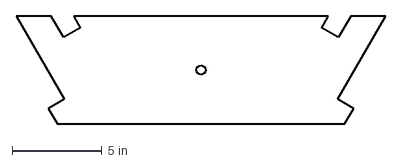
[picture p64: CAD file, 2016-05-05]
CAD/MotionBaseCAD/Real Platform/Drawings/Triangle End2.dxf
20.5 x 6.00 in
