Alexanderallenbrown/MotionBase/CAD/Motion Base Rough model/Sparco Volante wheel.IGS

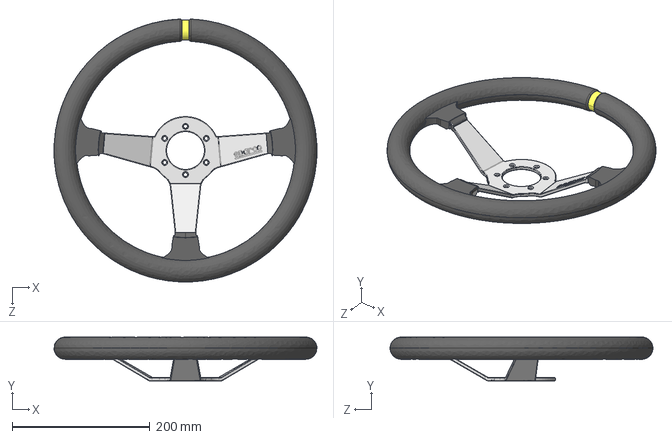
[picture p65: CAD file, 2016-02-03]
CAD/Motion Base Rough model/Sparco Volante wheel.IGS
382.3 x 63.8 x 382.0 mm
