Alexanderallenbrown/MotionBase/CAD/MotionBaseCAD/ControllerMount/buttonInchPipeMount.stl

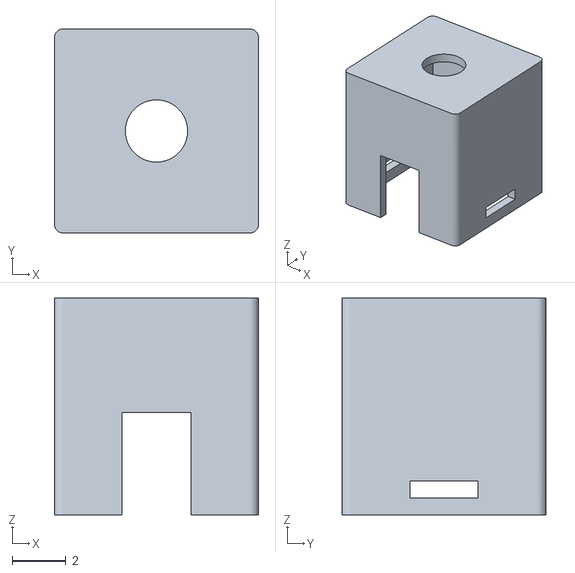
[picture p66: CAD file, 2016-08-09]
CAD/MotionBaseCAD/ControllerMount/buttonInchPipeMount.stl
7.62 x 7.62 x 8.09
