Alexanderallenbrown/MotionBase/CAD/MotionBaseCAD/RailSlide.STEP

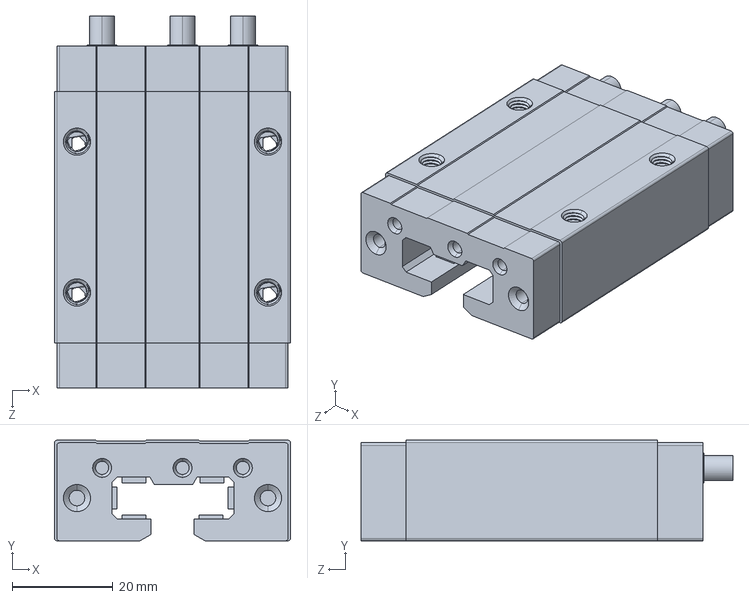
[picture p67: CAD file, 2016-03-02]
CAD/MotionBaseCAD/RailSlide.STEP
47.0 x 20.0 x 74.0 mm
