Alexanderallenbrown/MotionBase/CAD/MotionBaseCAD/Real Platform/Drawings/Motor_Shaft_Attachment.dxf

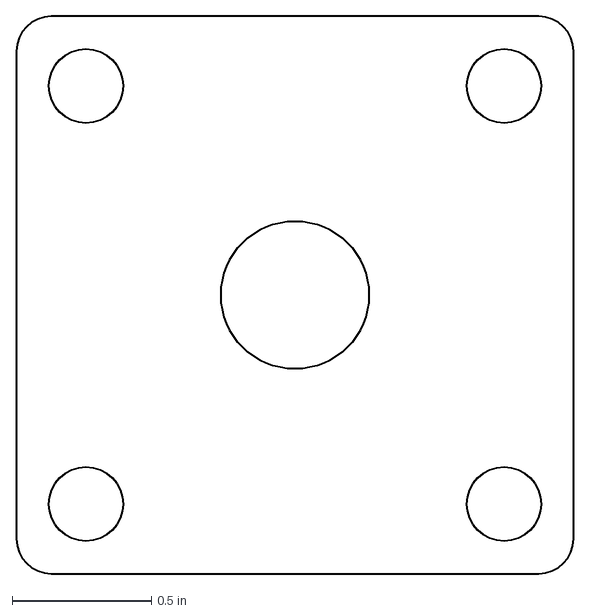
[picture p68: CAD file, 2016-05-05]
CAD/MotionBaseCAD/Real Platform/Drawings/Motor_Shaft_Attachment.dxf
2.00 x 2.00 in
