Alexanderallenbrown/MotionBase/CAD/MotionBaseCAD/Real Platform/Drawings/Triangle End.dxf

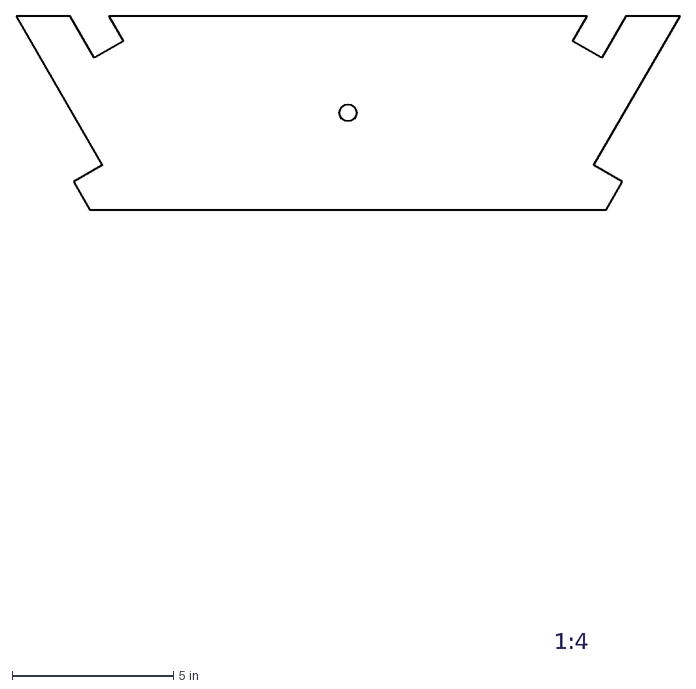
[picture p69: CAD file, 2016-04-10]
CAD/MotionBaseCAD/Real Platform/Drawings/Triangle End.dxf
1:4
