Alexanderallenbrown/MotionBase/CAD/MotionBaseCAD/WGA-50M-080-H1.STEP

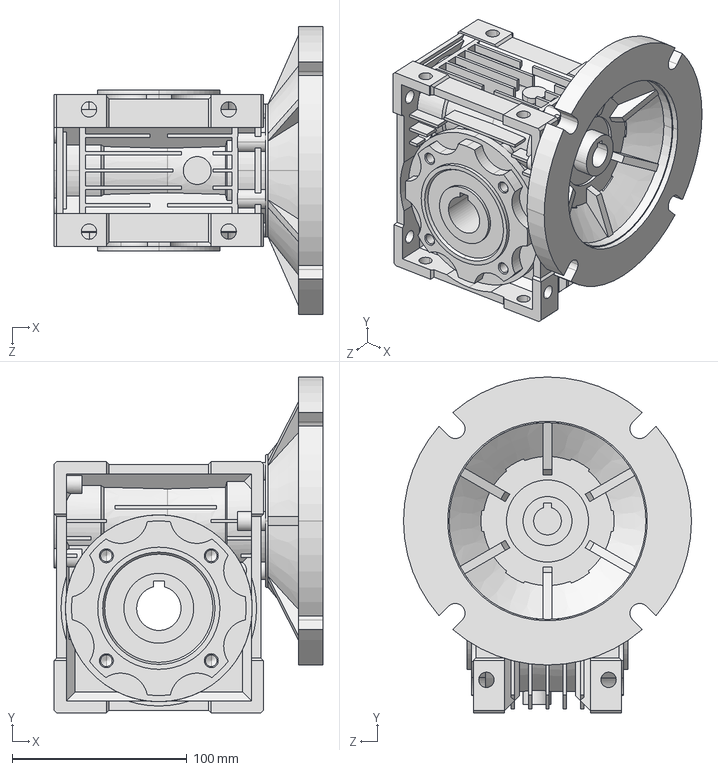
[picture p70: CAD file, 2016-02-24]
CAD/MotionBaseCAD/WGA-50M-080-H1.STEP
154.0 x 192.5 x 165.0 mm
