Alexanderallenbrown/MotionBase/CAD/MotionBaseCAD/Real Platform/Drawings/Motor_Arm.dxf

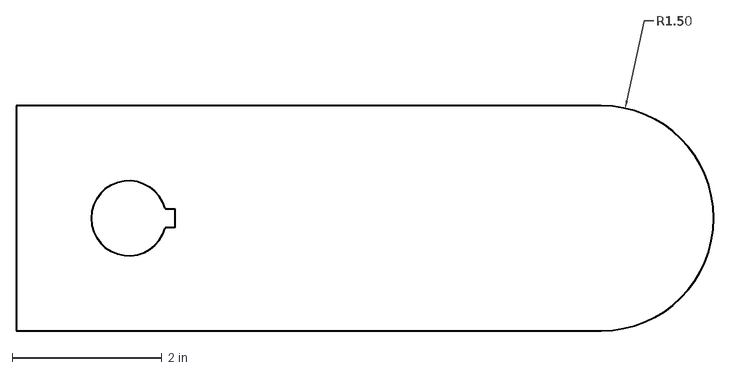
[picture p71: CAD file, 2016-04-10]
CAD/MotionBaseCAD/Real Platform/Drawings/Motor_Arm.dxf
R1.50
