Alexanderallenbrown/MotionBase/CAD/MotionBaseCAD/TMDF 180L.SLDPRT

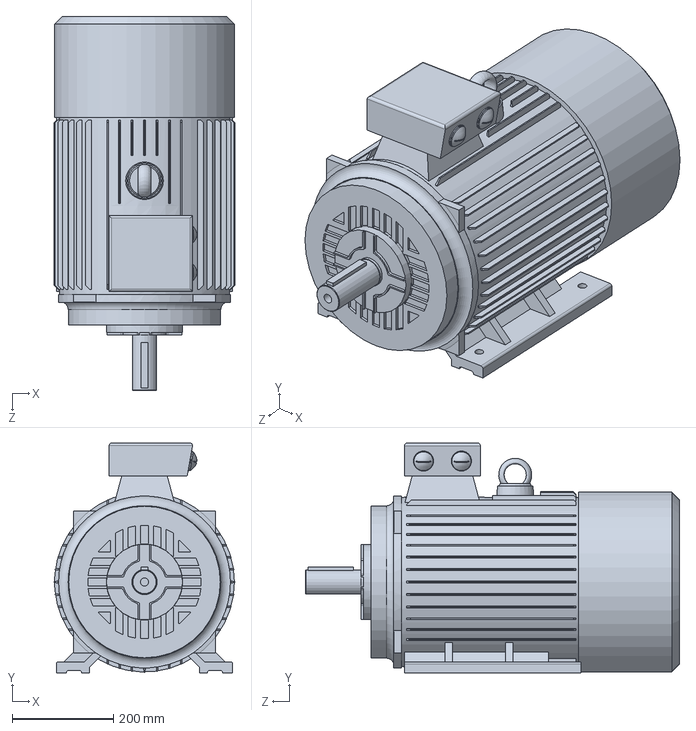
[picture p72: CAD file, 2016-02-24]
CAD/MotionBaseCAD/TMDF 180L.SLDPRT
358.0 x 455.0 x 740.0 mm
