Alexanderallenbrown/MotionBase/(list of files, cad)

Other CAD files:
CAD/MotionBaseCAD/Triangle End.dwg
CAD/Motion Base Rough model/24_inch_square.ipt
CAD/Motion Base Rough model/45degree_brace.ipt
CAD/Motion Base Rough model/48_Inch_square.ipt
CAD/Motion Base Rough model/60_inch_square.ipt
CAD/Motion Base Rough model/DMJ_Head.ipt
CAD/Motion Base Rough model/DMJ_Legs.ipt
CAD/Motion Base Rough model/DMJ_Waist.ipt
CAD/Motion Base Rough model/DMJ_arm.ipt
CAD/Motion Base Rough model/DMJ_hat.ipt
CAD/Motion Base Rough model/DMJ_torso.ipt
CAD/Motion Base Rough model/David_Mac_Jones.iam
CAD/Motion Base Rough model/Imported Components/siege/siege.ipt
CAD/Motion Base Rough model/MotionBaseRough.iam
CAD/Motion Base Rough model/OldVersions/24_inch_square.0001.ipt
CAD/Motion Base Rough model/OldVersions/60_inch_square.0001.ipt
CAD/Motion Base Rough model/OldVersions/DMJ_Legs.0002.ipt
CAD/Motion Base Rough model/OldVersions/DMJ_arm.0001.ipt
CAD/Motion Base Rough model/OldVersions/DMJ_hat.0001.ipt
CAD/Motion Base Rough model/OldVersions/DMJ_torso.0003.ipt
CAD/Motion Base Rough model/OldVersions/David_Mac_Jones.0001.iam
CAD/Motion Base Rough model/OldVersions/MotionBaseRough.0002.iam
CAD/Motion Base Rough model/OldVersions/Television.0002.ipt
CAD/Motion Base Rough model/Square_30degree.ipt
CAD/MotionBaseCAD/00 - Pedalier CSP V2.iam
CAD/MotionBaseCAD/1inSquareSupport.ipt
CAD/MotionBaseCAD/1inSquareSupport2.ipt
CAD/MotionBaseCAD/1inSquareSupportOut.ipt
CAD/MotionBaseCAD/BasePlatform.ipt
CAD/MotionBaseCAD/BaseSkirt/Assembly1.iam
CAD/MotionBaseCAD/BaseSkirt/FullSkirt.iam
CAD/MotionBaseCAD/BaseSkirt/LargeHorizBeam.ipt
CAD/MotionBaseCAD/BaseSkirt/LargeSideHook.ipt
CAD/MotionBaseCAD/BaseSkirt/LargeSkirtWall.iam
CAD/MotionBaseCAD/BaseSkirt/OldVersions/FullSkirt.0003.iam
CAD/MotionBaseCAD/BaseSkirt/OldVersions/LargeHorizBeam.0002.ipt
CAD/MotionBaseCAD/BaseSkirt/OldVersions/LargeSideHook.0001.ipt
CAD/MotionBaseCAD/BaseSkirt/OldVersions/LargeSkirtWall.0001.iam
CAD/MotionBaseCAD/BaseSkirt/OldVersions/SmallHorizBeam.0003.ipt
CAD/MotionBaseCAD/BaseSkirt/OldVersions/SmallSideHook.0002.ipt
CAD/MotionBaseCAD/BaseSkirt/OldVersions/SmallSkirtWall.0001.iam
CAD/MotionBaseCAD/BaseSkirt/OldVersions/VertBeam.0002.ipt
CAD/MotionBaseCAD/BaseSkirt/Part2.ipt
CAD/MotionBaseCAD/BaseSkirt/SmallHorizBeam.ipt
CAD/MotionBaseCAD/BaseSkirt/SmallSideHook.ipt
CAD/MotionBaseCAD/BaseSkirt/SmallSkirtWall.iam
CAD/MotionBaseCAD/BaseSkirt/VertBeam.ipt
CAD/MotionBaseCAD/Bearing.ipt
CAD/MotionBaseCAD/Chair Support Side.ipt
CAD/MotionBaseCAD/Chair.iam
CAD/MotionBaseCAD/Char Support Base.ipt
CAD/MotionBaseCAD/ControllerMount/2ndVert.ipt
CAD/MotionBaseCAD/ControllerMount/ClampSide.ipt
CAD/MotionBaseCAD/ControllerMount/ClampTo.ipt
CAD/MotionBaseCAD/ControllerMount/ControllerClamp.iam
CAD/MotionBaseCAD/ControllerMount/ControllerMount.iam
CAD/MotionBaseCAD/ControllerMount/FrontHoriz.ipt
CAD/MotionBaseCAD/ControllerMount/FrontHorizTop.ipt
CAD/MotionBaseCAD/ControllerMount/HeelBar.ipt
CAD/MotionBaseCAD/ControllerMount/InitialHoriz.ipt
CAD/MotionBaseCAD/ControllerMount/InitialVert.ipt
CAD/MotionBaseCAD/ControllerMount/LegBracing.ipt
CAD/MotionBaseCAD/ControllerMount/LegExtrusion.ipt
CAD/MotionBaseCAD/ControllerMount/OldVersions/2ndVert.0003.ipt
CAD/MotionBaseCAD/ControllerMount/OldVersions/ClampTo.0001.ipt
CAD/MotionBaseCAD/ControllerMount/OldVersions/ControllerMount.0004.iam
CAD/MotionBaseCAD/ControllerMount/OldVersions/FrontHoriz.0003.ipt
CAD/MotionBaseCAD/ControllerMount/OldVersions/FrontHorizTop.0001.ipt
CAD/MotionBaseCAD/ControllerMount/OldVersions/HeelBar.0002.ipt
CAD/MotionBaseCAD/ControllerMount/OldVersions/InitialHoriz.0002.ipt
CAD/MotionBaseCAD/ControllerMount/OldVersions/InitialVert.0002.ipt
CAD/MotionBaseCAD/ControllerMount/OldVersions/LegBracing.0001.ipt
CAD/MotionBaseCAD/ControllerMount/OldVersions/LegExtrusion.0003.ipt
CAD/MotionBaseCAD/ControllerMount/OldVersions/SteelPipe12in.0001.ipt
CAD/MotionBaseCAD/ControllerMount/OldVersions/buttonInchPipeMount.0001.ipt
CAD/MotionBaseCAD/ControllerMount/SharpCap.ipt
CAD/MotionBaseCAD/ControllerMount/SteelPipe12in.ipt
CAD/MotionBaseCAD/ControllerMount/SteelPipe16in.ipt
CAD/MotionBaseCAD/ControllerMount/buttonInchPipeMount.ipt
CAD/MotionBaseCAD/Front Rail.ipt
CAD/MotionBaseCAD/GearShaft.ipt
CAD/MotionBaseCAD/Imported Components/TMDF 180L/TMDF 180L.ipt
CAD/MotionBaseCAD/Imported Components/WGA-50M-080-H1/OldVersions/WGA-50M-080-H1.0001.ipt
CAD/MotionBaseCAD/Imported Components/WGA-50M-080-H1/WGA-50M-080-H1.ipt
CAD/MotionBaseCAD/MotionBaseFixed-referenceDimensions.idw
CAD/MotionBaseCAD/MotionBaseFixed2.iam
CAD/MotionBaseCAD/MotionBaseGeneric.iam
CAD/MotionBaseCAD/Motor Shim.ipt
CAD/MotionBaseCAD/Motor.ipt
CAD/MotionBaseCAD/Motor3.ipt
CAD/MotionBaseCAD/Motor4.ipt
CAD/MotionBaseCAD/Motor5.ipt
CAD/MotionBaseCAD/MotorCovers/LeftCover/InsideWall.ipt
CAD/MotionBaseCAD/MotorCovers/LeftCover/LeftMotorCover.iam
CAD/MotionBaseCAD/MotorCovers/LeftCover/OldVersions/InsideWall.0002.ipt
CAD/MotionBaseCAD/MotorCovers/LeftCover/OldVersions/LeftMotorCover.0002.iam
CAD/MotionBaseCAD/MotorCovers/LeftCover/OldVersions/OutsideWall.0003.ipt
CAD/MotionBaseCAD/MotorCovers/LeftCover/OldVersions/SideWall.0005.ipt
CAD/MotionBaseCAD/MotorCovers/LeftCover/OldVersions/TopWall.0002.ipt
CAD/MotionBaseCAD/MotorCovers/LeftCover/OutsideWall.ipt
CAD/MotionBaseCAD/MotorCovers/LeftCover/SideWall.ipt
CAD/MotionBaseCAD/MotorCovers/LeftCover/TopWall.ipt
CAD/MotionBaseCAD/MotorCovers/OldVersions/OutsideWall.0001.ipt
CAD/MotionBaseCAD/MotorCovers/OldVersions/OutsideWall.0002.ipt
CAD/MotionBaseCAD/MotorCovers/OldVersions/SideWall.0003.ipt
CAD/MotionBaseCAD/MotorCovers/OldVersions/SideWall.0004.ipt
CAD/MotionBaseCAD/MotorCovers/OldVersions/TopWall.0001.ipt
CAD/MotionBaseCAD/MotorCovers/RightCover/InsideRWall.ipt
CAD/MotionBaseCAD/MotorCovers/RightCover/OldVersions/InsideRWall.0001.ipt
CAD/MotionBaseCAD/MotorCovers/RightCover/OldVersions/OustideRWall.0001.ipt
CAD/MotionBaseCAD/MotorCovers/RightCover/OldVersions/OutsideRWall.0001.ipt
CAD/MotionBaseCAD/MotorCovers/RightCover/OldVersions/OutsideRWall.0001_1.ipt
CAD/MotionBaseCAD/MotorCovers/RightCover/OldVersions/OutsideRWall.0001_2.ipt
CAD/MotionBaseCAD/MotorCovers/RightCover/OldVersions/OutsideRWall.0002.ipt
CAD/MotionBaseCAD/MotorCovers/RightCover/OldVersions/RightCover.0002.iam
CAD/MotionBaseCAD/MotorCovers/RightCover/OldVersions/SideRWall.0001.ipt
CAD/MotionBaseCAD/MotorCovers/RightCover/OldVersions/SideRWall.0001_1.ipt
CAD/MotionBaseCAD/MotorCovers/RightCover/OldVersions/TopRWall.0001.ipt
CAD/MotionBaseCAD/MotorCovers/RightCover/OutsideRWall.ipt
CAD/MotionBaseCAD/MotorCovers/RightCover/RightCover.iam
CAD/MotionBaseCAD/MotorCovers/RightCover/SideRWall.ipt
CAD/MotionBaseCAD/MotorCovers/RightCover/TopRWall.ipt
CAD/MotionBaseCAD/MotorRail.iam
CAD/MotionBaseCAD/MotorRail2.iam
CAD/MotionBaseCAD/OldVersions/00 - Pedalier CSP V2.0002.iam
CAD/MotionBaseCAD/OldVersions/1inSquareSupport2.0009.ipt
CAD/MotionBaseCAD/OldVersions/1inSquareSupportOut.0004.ipt
CAD/MotionBaseCAD/OldVersions/BasePlatform.0003.ipt
CAD/MotionBaseCAD/OldVersions/BasePlatform.0004.ipt
CAD/MotionBaseCAD/OldVersions/BasePlatform.0005.ipt
CAD/MotionBaseCAD/OldVersions/Bearing.0003.ipt
CAD/MotionBaseCAD/OldVersions/Chair.0003.iam
CAD/MotionBaseCAD/OldVersions/Front Rail.0002.ipt
CAD/MotionBaseCAD/OldVersions/GearShaft.0006.ipt
CAD/MotionBaseCAD/OldVersions/MotionBaseFixed.0012.iam
CAD/MotionBaseCAD/OldVersions/MotionBaseFixed.0014.iam
CAD/MotionBaseCAD/OldVersions/MotionBaseFixed2.0013.iam
CAD/MotionBaseCAD/OldVersions/MotionBaseGeneric.0047.iam
CAD/MotionBaseCAD/OldVersions/Motor Shim.0002.ipt
CAD/MotionBaseCAD/OldVersions/Motor3.0001.ipt
CAD/MotionBaseCAD/OldVersions/Motor4.0007.ipt
CAD/MotionBaseCAD/OldVersions/Motor5.0005.ipt
CAD/MotionBaseCAD/OldVersions/MotorRail.0017.iam
CAD/MotionBaseCAD/OldVersions/MotorRail.0018.iam
CAD/MotionBaseCAD/OldVersions/Platform.0004.ipt
CAD/MotionBaseCAD/OldVersions/PlatformTop.0002.ipt
CAD/MotionBaseCAD/OldVersions/Rod.0001.ipt
CAD/MotionBaseCAD/OldVersions/Rod_MIR.0001.ipt
CAD/MotionBaseCAD/OldVersions/Side Rail.0001.ipt
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
