Alexanderallenbrown/MotionBase/figures/Worm_final_drive_.Manual_of_Driving_and_Maintenance.jpg

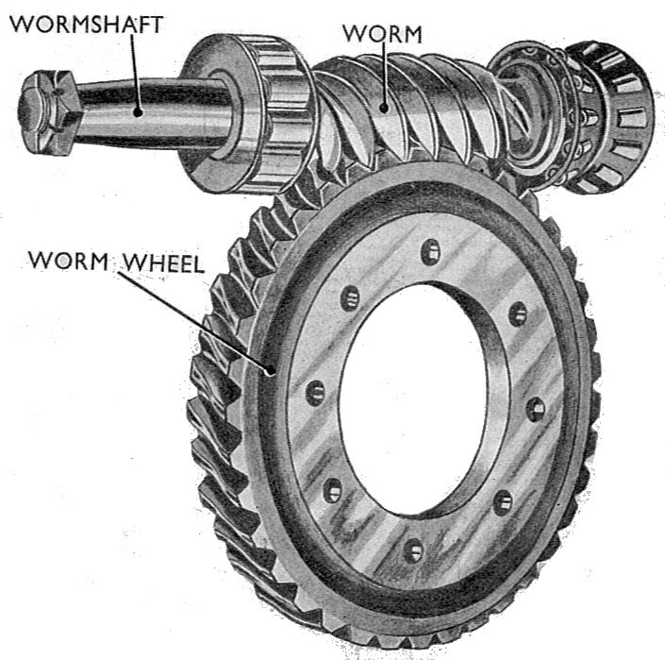
figures/Worm_final_drive_.Manual_of_Driving_and_Maintenance.jpg
