Alexanderallenbrown/MotionBase/(threads)

Thread 4 (2016-02-17):

Please check to make sure hii.m is the latest version

dallisg711, 2016-02-17:
@wangzeyi please make sure your leg fixes are still there in hii.m. If they are not, please update the file from the lab computer.

wangzeyi, 2016-02-17:
@dallisg711 no problem!

wangzeyi, 2016-02-18:
@dallisg711  they are good!

Closed 2016-02-19.

Thread 12 (2016-03-07):

Fix calculation of angular accels and linear accels in torque_calcs.m

Alexanderallenbrown, 2016-03-07:
What I mean by this is simply that right now, these are calculated inside the "for" loop for time. Instead, after running the simulation, do something like:

omega_x_desired = [0; diff(tiltx)./diff(simtime)];
alpha_x_desired = [0; diff(omega_x_desired)./diff(simtime)];

and similar stuff with the linear accelerations.

Closed 2016-03-09.

Thread 13 (2016-03-07):

Fix use of forceplatform.m to use linear accels (currently uses linear positions)

Alexanderallenbrown, 2016-03-07:
We currently send motion_des() to force platform.m but I believe this function is supposed to take linear **accelerations**.

megantuttle, 2016-03-09:
fixed with commit 029cc2a

Closed 2016-03-09.

Thread 14 (2016-03-07):

switch angle solver to bisection method

Alexanderallenbrown, 2016-03-07:
At your convenience, borrow the bisection code from Dallis's branch High-Pass-Filter-Creation and add to your platform position code, instead of using fminsearch. This will prevent us from requesting motor angles outside of the range (0, pi/2)

megantuttle, 2016-03-14:
fixed with commit  28dc1d1

Closed 2016-03-14.

Thread 16 (2016-03-19):

Work on inverter today?

wangzeyi, 2016-03-19:
Hello Professor @Alexanderallenbrown :

Shall we work on the inverter today?

@macjones743 @dallisg711

Alexanderallenbrown, 2016-03-19:
Hey Andy

You can work on it if you wish. Please send me an email when you are ready to plug it in for the first time so I can drop by and check the wiring.

Sent from my iPhone

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

wangzeyi, 2016-03-19:
Hello professor @Alexanderallenbrown:

There are three wires from the source, and the inverter only takes two wires, how do we do that?

Alexanderallenbrown, 2016-03-19:
There are two screws on the bottom of the case that are for the green ground wire. This is true of both the  motor and the source cable.

Sent from my iPhone

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

wangzeyi, 2016-03-20:
@macjones743  the code is fixed! I made a terrible mistake.

Want to connect the arduino to the inverter to test the code, and work on position control?

wangzeyi, 2016-03-21:
Hello professor @Alexanderallenbrown

I was testing our transistors, and found that one of them was not working! @macjones743
Where can we get a good tramsistor?

Closed 2016-04-18.

Thread 19 (2016-05-02):

control system design page is missing details about low-level control and sensing.

Alexanderallenbrown, 2016-05-02:

Alexanderallenbrown, 2016-05-03:
by this, I am referring to the individual motor control. we should be talking about what kinds of sensors there are, what the gains are, if/why we don't use kd, the deadband (+/- 20 counts error), any clamps/checks in the algorithm, gain selection, etc.

Thread 20 (2017-05-17):

Document new Arduino shield and cable/panel system

Alexanderallenbrown, 2017-05-17:
Drawings, code, CAD, pictures, and descriptions on Wiki. All designs should be added to the repository in an appropriate place.
