Alexanderallenbrown/MotionBase/CAD/MotionBaseCAD/Base.pdf

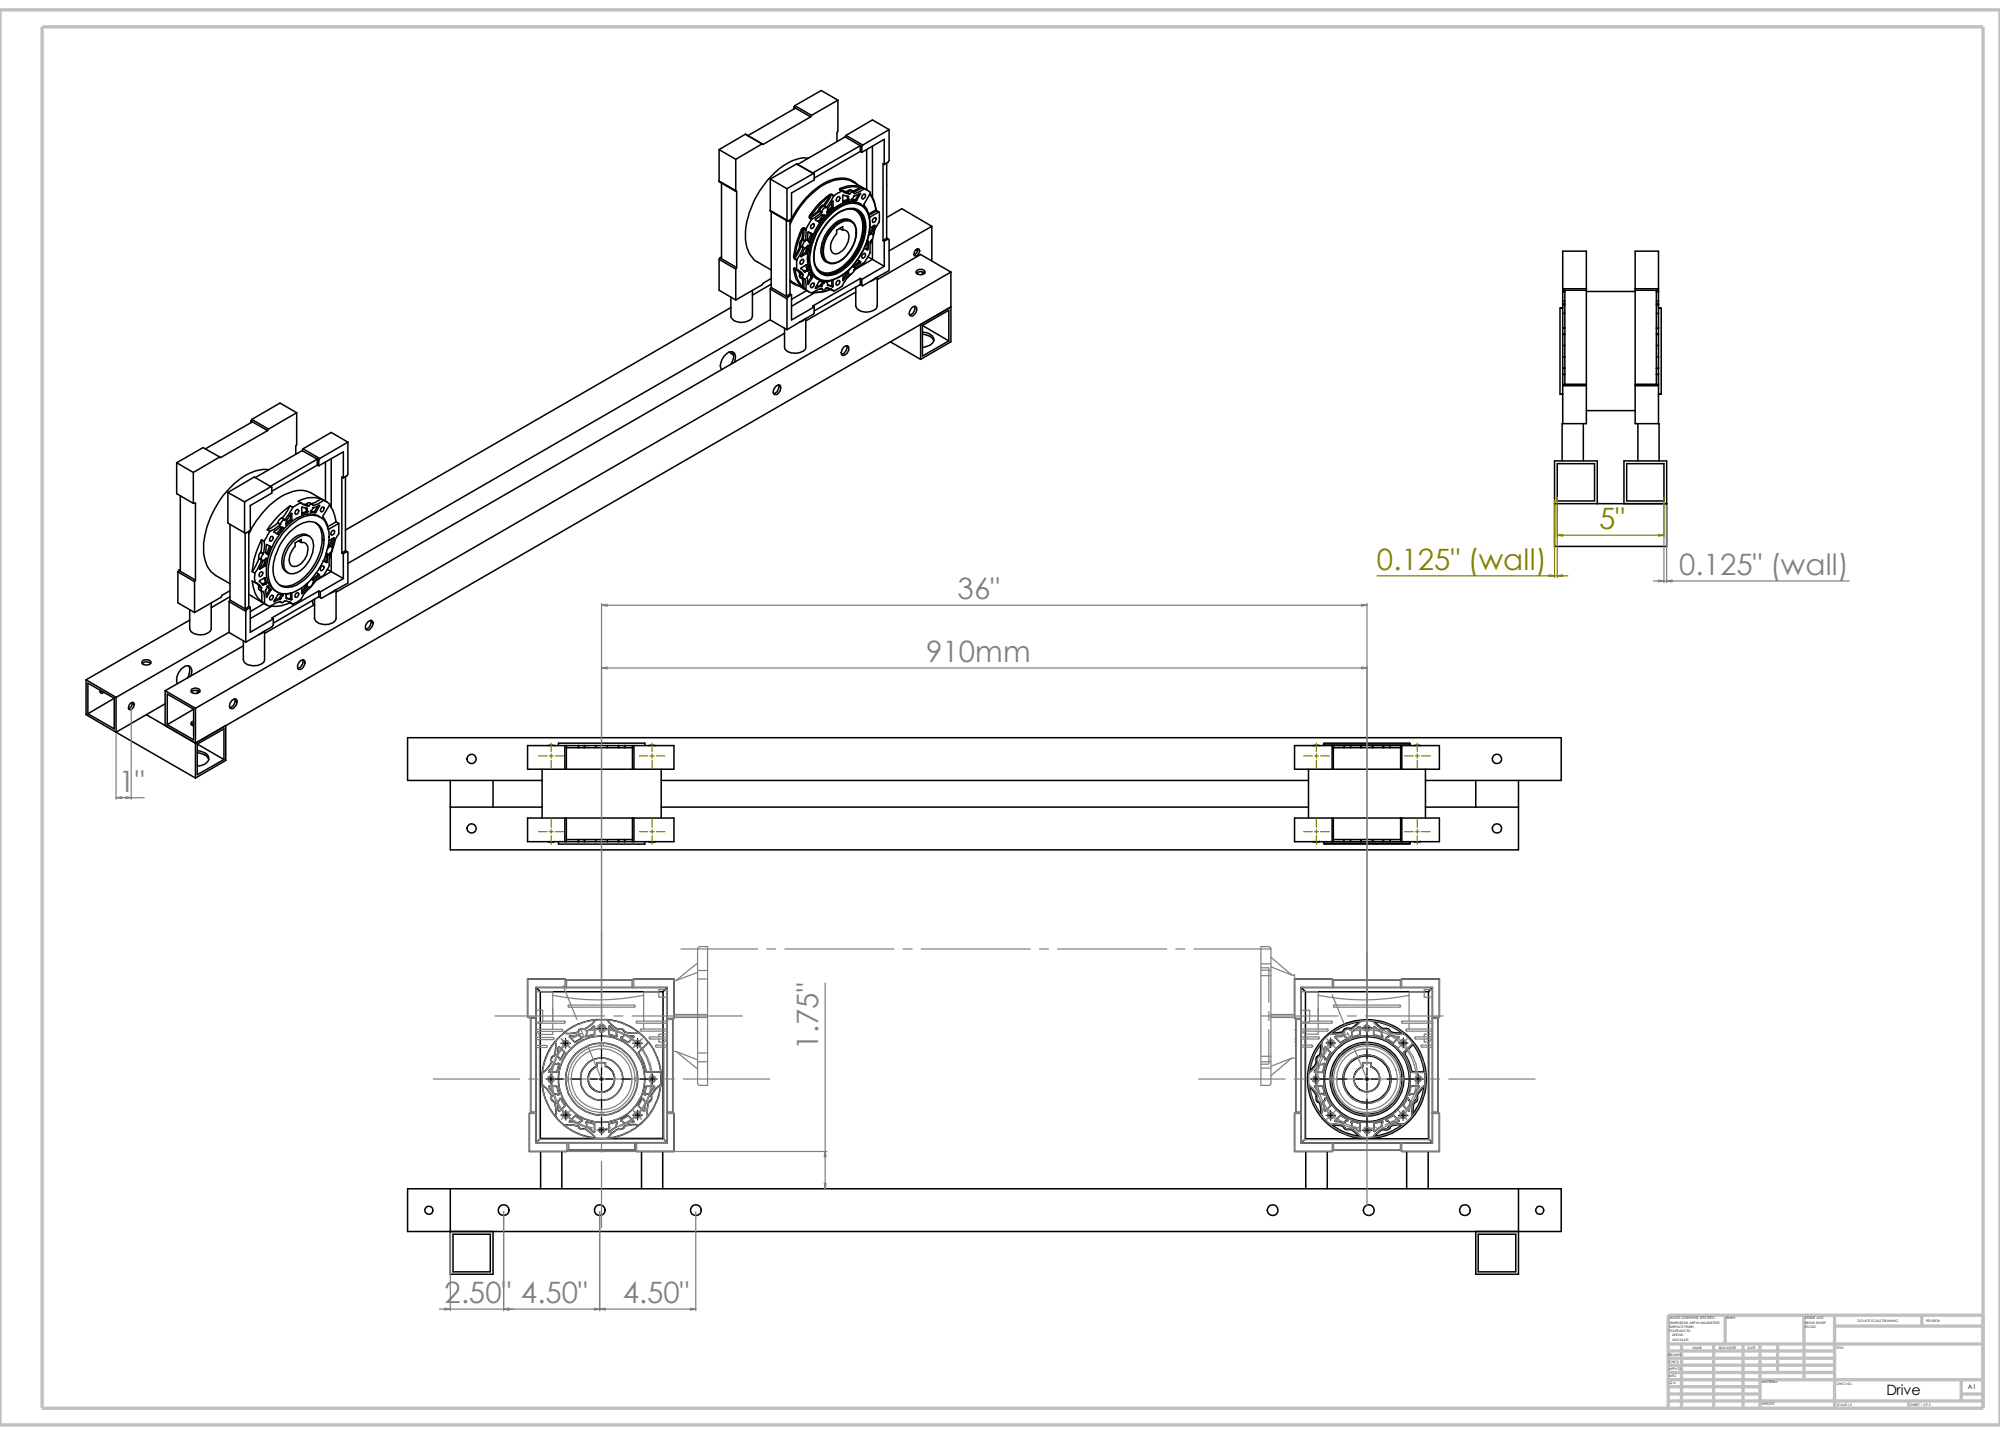
[picture p74: page 1]
Drive; DO NOT SCALE DRAWING; REVISION; MATERIAL:; EDGES; FINISH:; BREAK SHARP; DEBUR AND; 0.125" (wall)

UNLESS OTHERWISE SPECIFIED:
DIMENSIONS ARE IN MILLIMETERS
SURFACE FINISH:
TOLERANCES:
LINEAR:
ANGULAR:

DRAWN | NAME | SIGNATURE | DATE | | | TITLE:
CHK'D
APPV'D
MFG
Q.A | | | | DWG NO. | A1

WEIGHT: | SCALE:1:5 SHEET 1 OF 2

1" ²¹.68mm | 76.20mm 5.25 0.85" | 1.15" | 0.85" 1.15"
3.00" 29.13mm

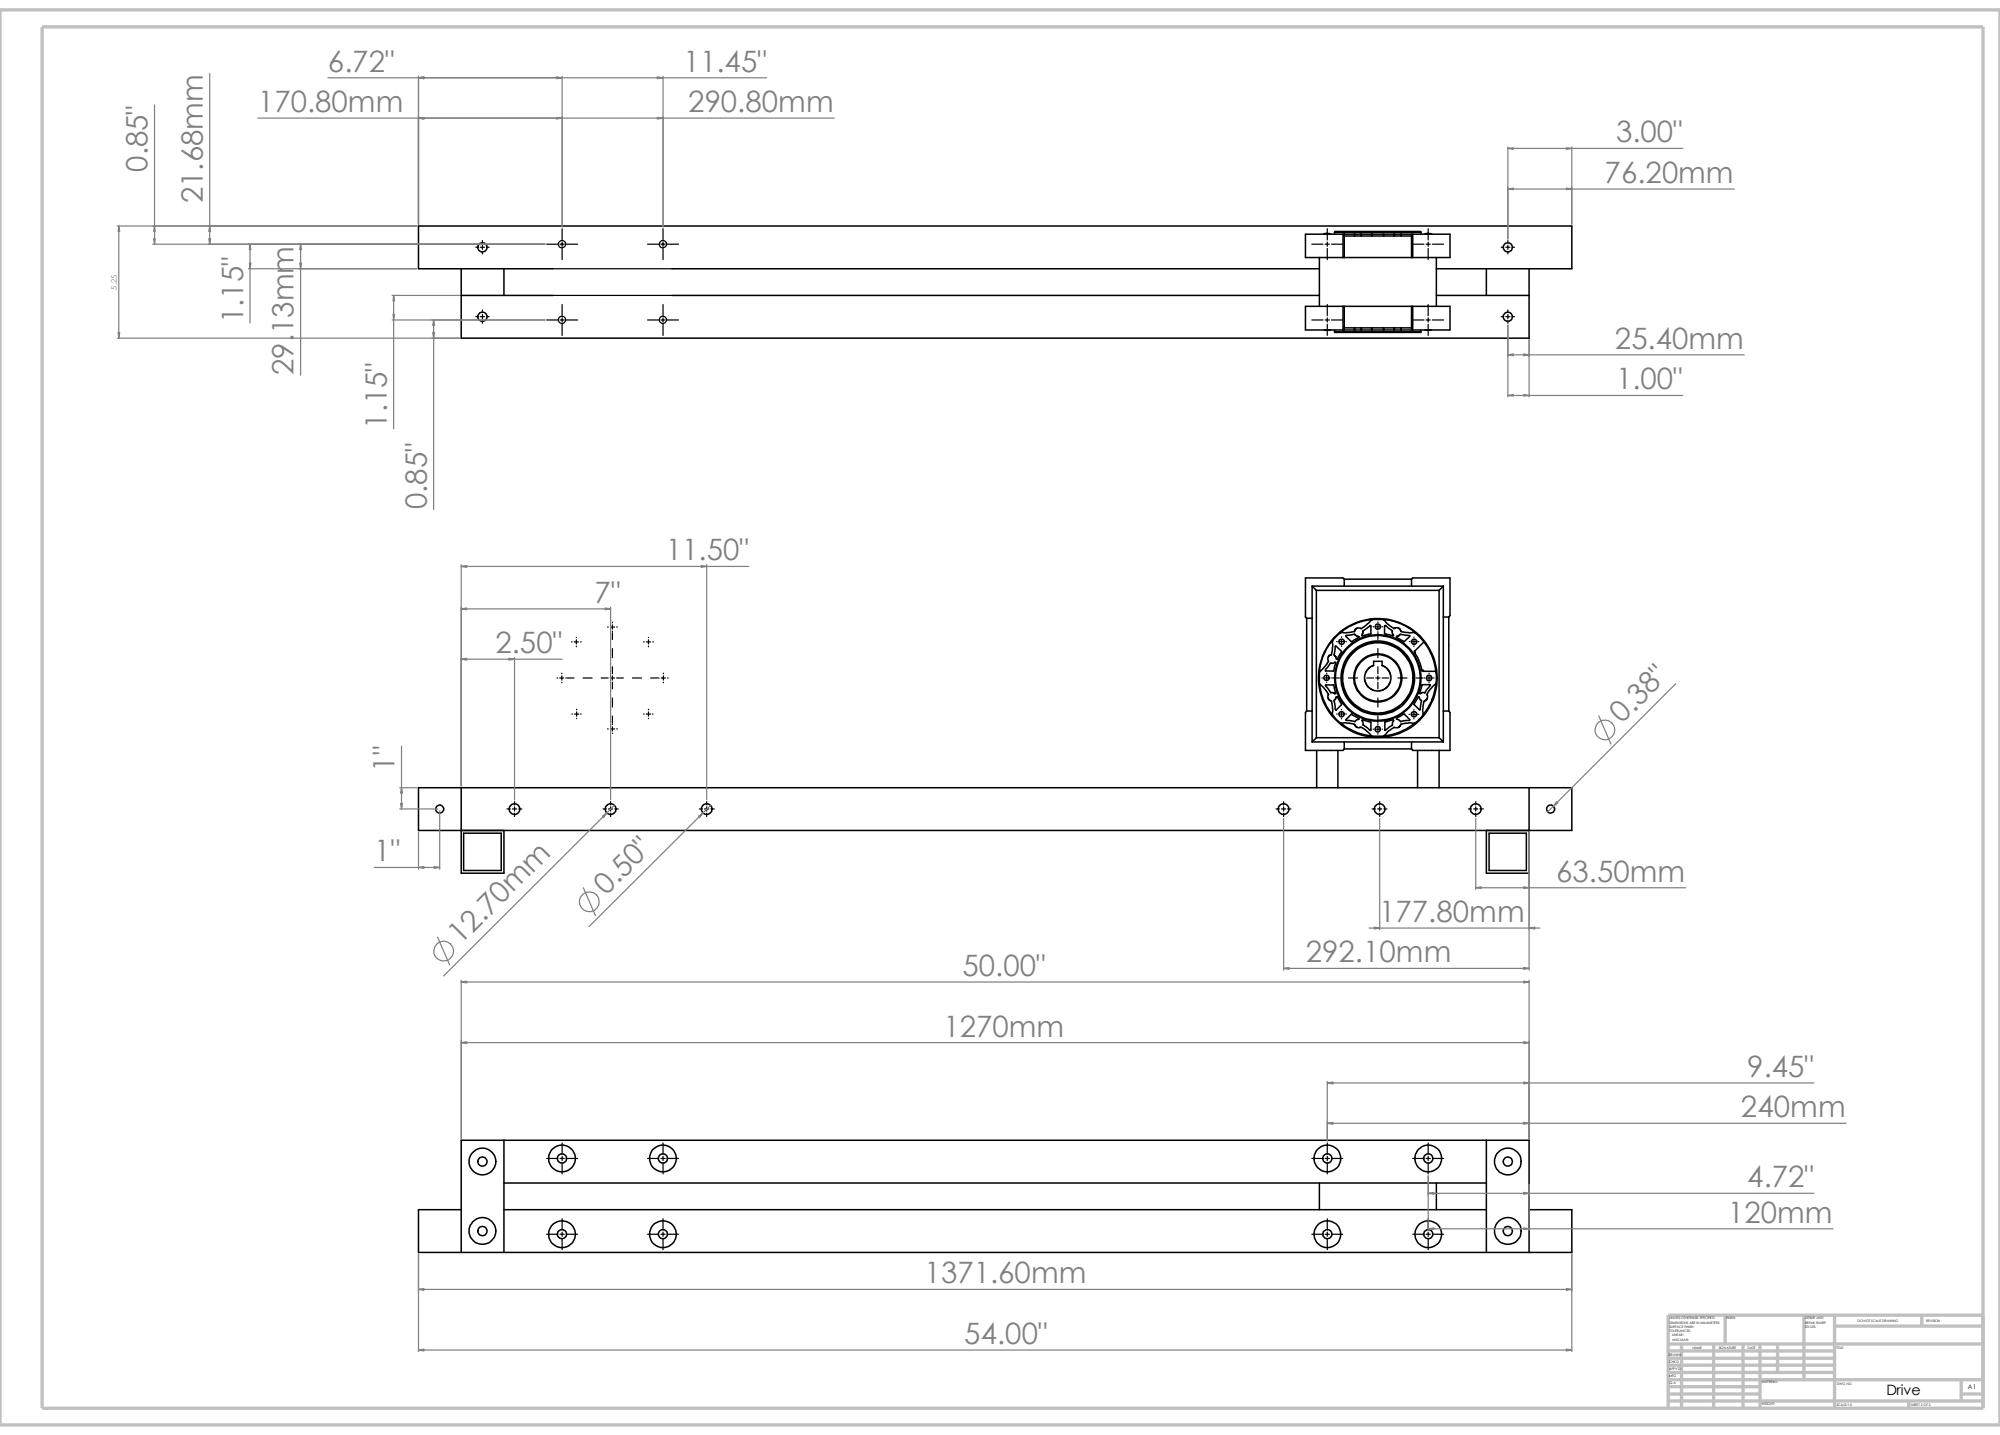
[picture p75: page 2]
Drive; DO NOT SCALE DRAWING; REVISION; MATERIAL:; DEBUR AND EDGES; BREAK SHARP; UNLESS OTHERWISE SPECIFIED:; FINISH:

DIMENSIONS ARE IN MILLIMETERS
SURFACE FINISH:
TOLERANCES:
LINEAR:
ANGULAR:

DRAWN | NAME | SIGNATURE | DATE | | | TITLE:
CHK'D
APPV'D
MFG
Q.A | | | | DWG NO. | A1

WEIGHT: | SCALE:1:5 SHEET 2 OF 2
