Alexanderallenbrown/MotionBase/CAD/MotionBaseCAD/Platform.pdf

4"

8" 20"

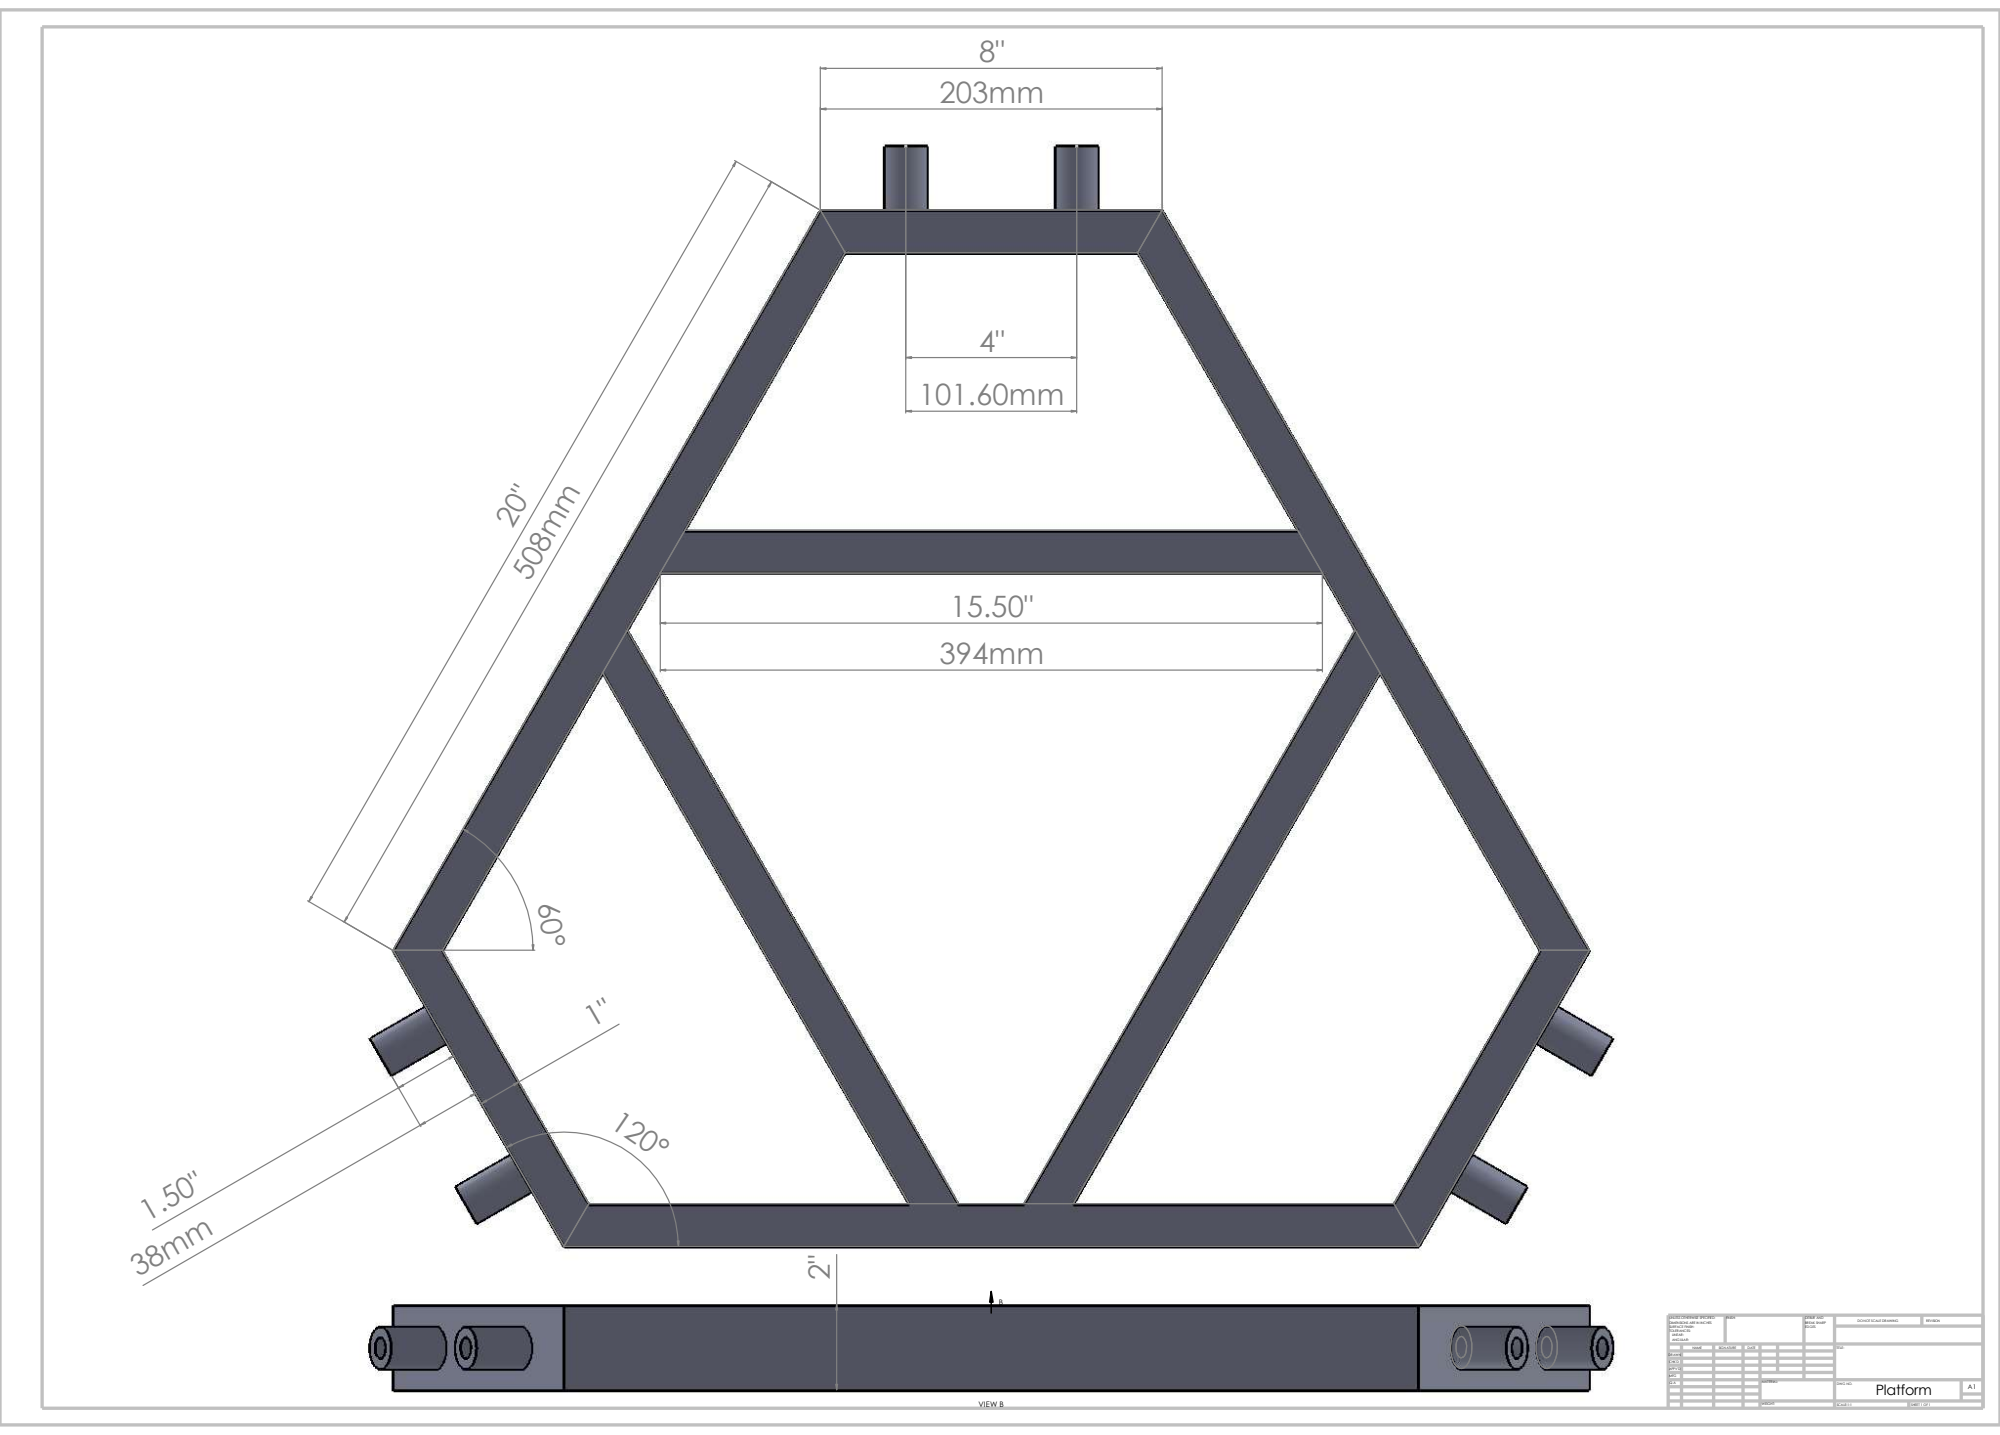
[picture p76: page 1]
Platform; DO NOT SCALE DRAWING; REVISION; MATERIAL:; EDGES; FINISH:; BREAK SHARP; DEBUR AND; 1" ⁵⁰⁸mm; VIEW B ²"

UNLESS OTHERWISE SPECIFIED:
DIMENSIONS ARE IN INCHES
SURFACE FINISH:
TOLERANCES:
LINEAR:
ANGULAR:

DRAWN | NAME | SIGNATURE | DATE | | | TITLE:
CHK'D
APPV'D
MFG
Q.A | | | | DWG NO. | A1

WEIGHT: | SCALE:1:1 SHEET 1 OF 1
