Alexanderallenbrown/MotionBase/CAD/MotionBaseCAD/Rod.pdf

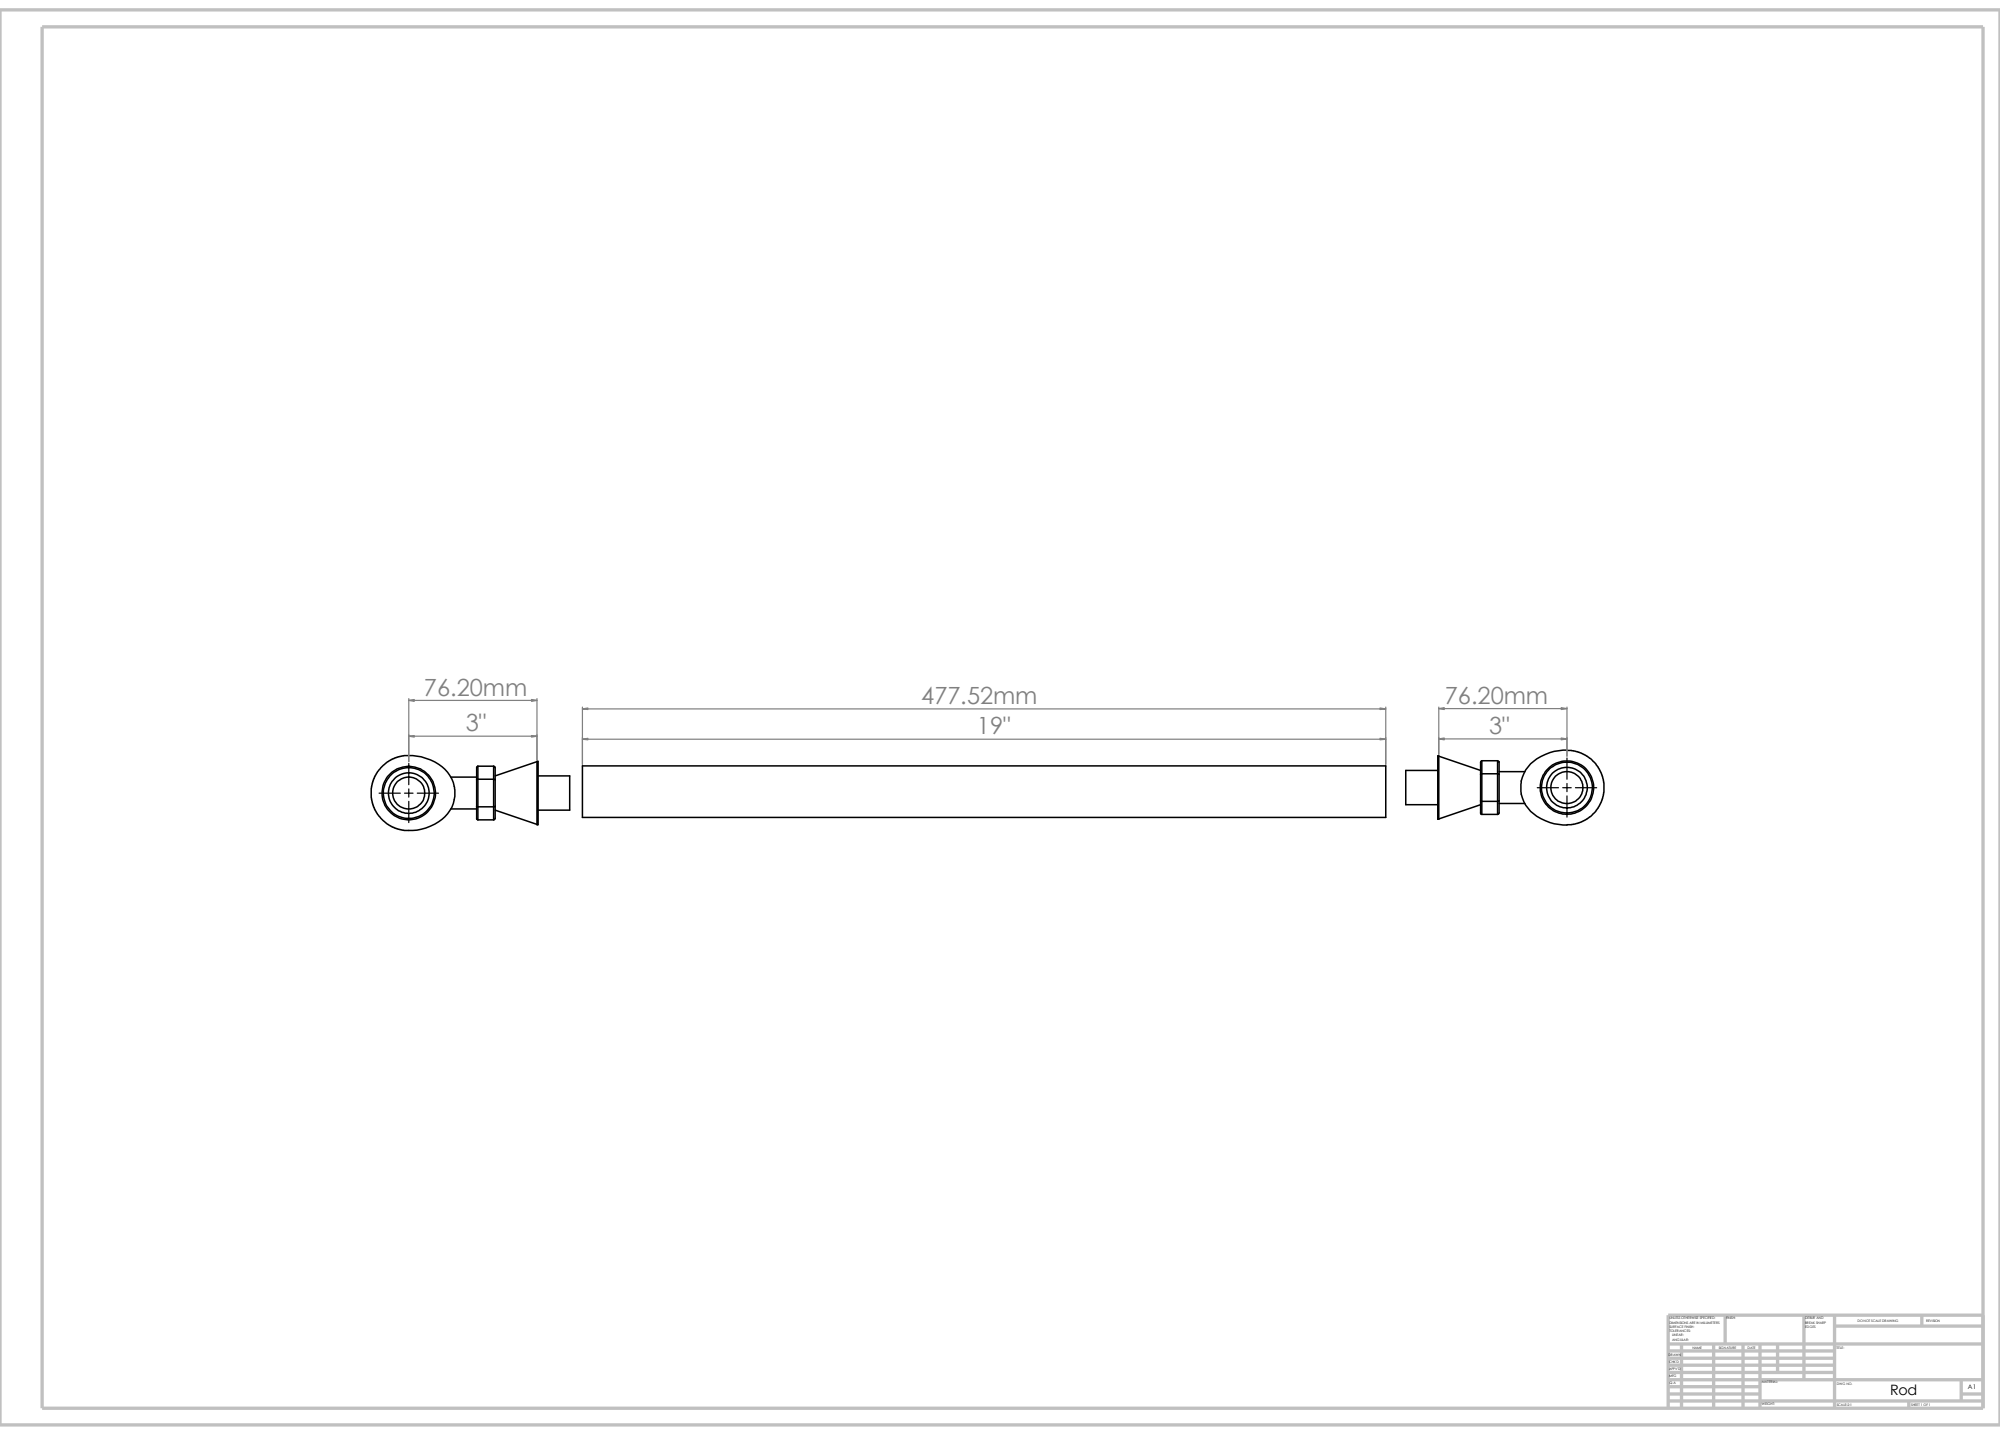
[picture p77: page 1]
EDGES; FINISH:; Rod; DEBUR AND; MATERIAL:; BREAK SHARP; REVISION

UNLESS OTHERWISE SPECIFIED:
DIMENSIONS ARE IN MILLIMETERS
SURFACE FINISH:
TOLERANCES:
LINEAR:
ANGULAR:

DO NOT SCALE DRAWING

DRAWN | NAME | SIGNATURE | DATE | | | TITLE:
CHK'D
APPV'D
MFG
Q.A | | | | DWG NO. | A1

WEIGHT: | SCALE:2:1 SHEET 1 OF 1
