Alexanderallenbrown/MotionBase/CAD/MotionBaseCAD/Real Platform/Drawings/PDFs/1inSquareSupport2.pdf

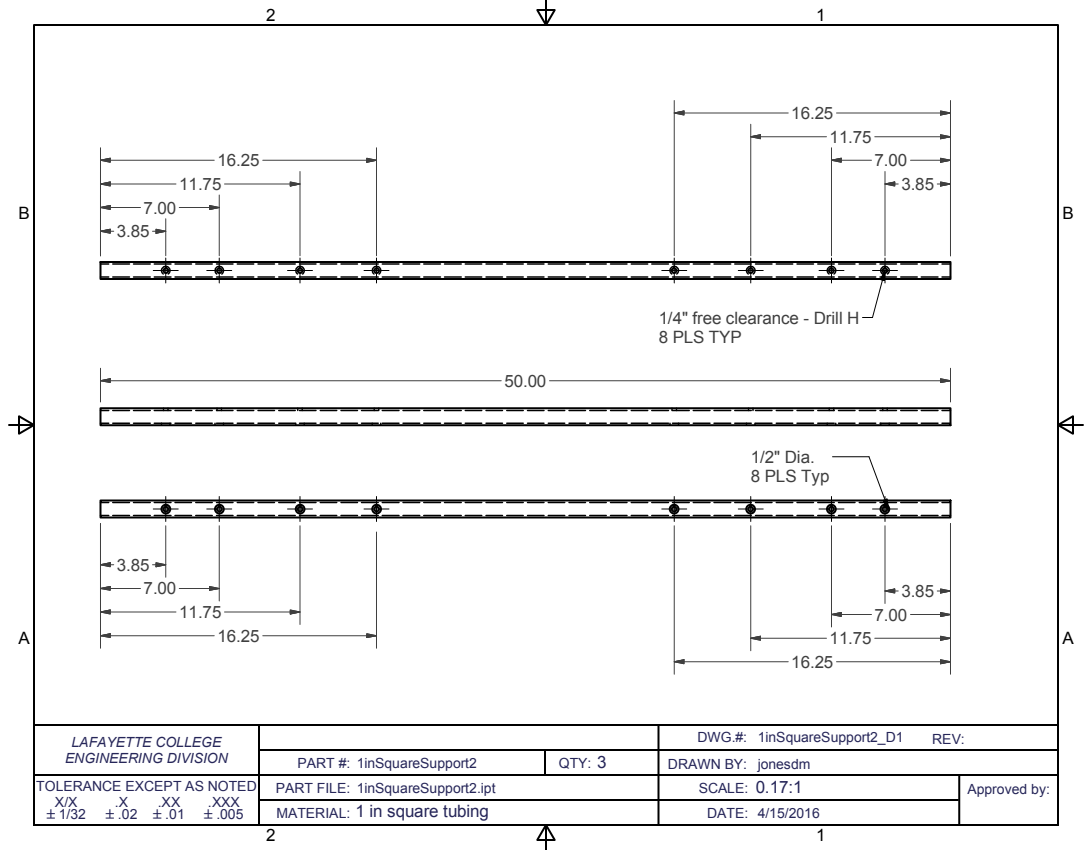
[picture p78: page 1]
1/2" Dia. 8 PLS Typ

1/4" free clearance - Drill H
8 PLS TYP

LAFAYETTE COLLEGE ENGINEERING DIVISION | | DWG.#: 1inSquareSupport2_D1 REV:

PART #: 1inSquareSupport2 | 3 QTY: | DRAWN BY: jonesdm

TOLERANCE EXCEPT AS NOTED X/X .X .XX .XXX B1/32 B.02 B.01 B.005 | PART FILE: 1inSquareSupport2.ipt | 0.17:1 SCALE: | Approved by:

1 in square tubing MATERIAL: | DATE: 4/15/2016
