Alexanderallenbrown/MotionBase/CAD/MotionBaseCAD/Real Platform/Drawings/PDFs/1inSquareSupportOut.pdf

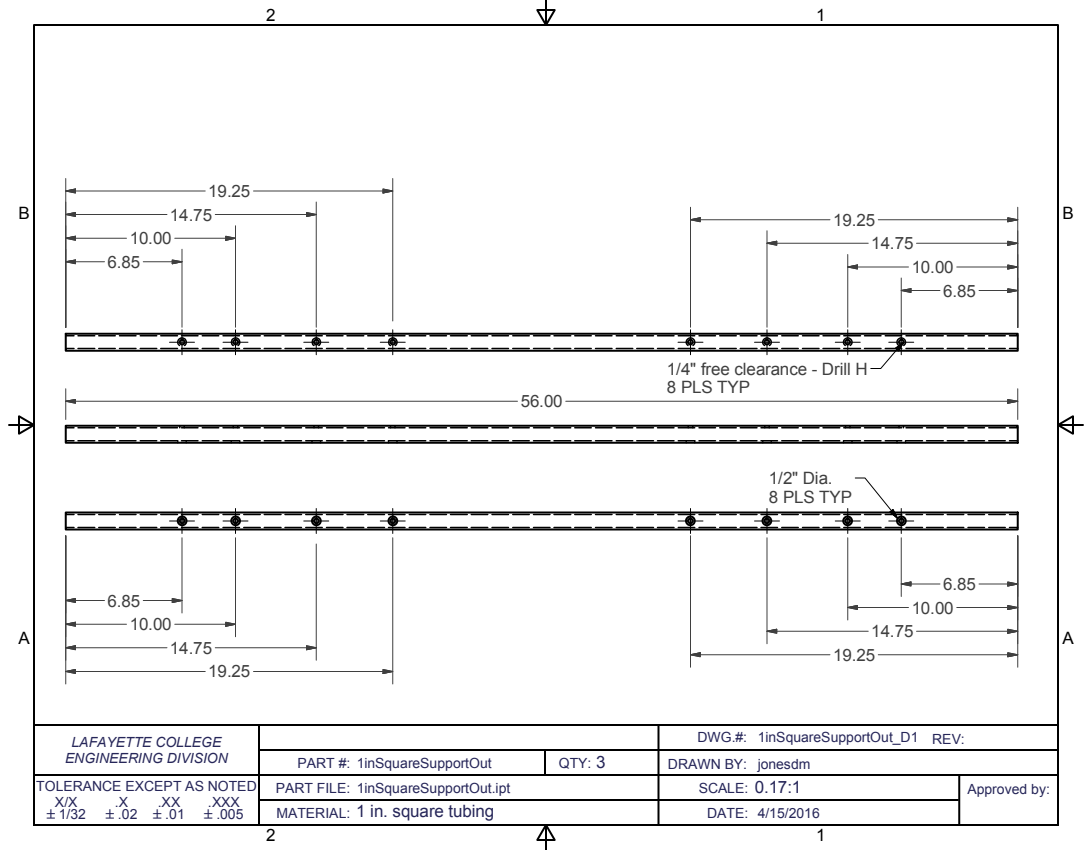
[picture p79: page 1]
1/2" Dia. 8 PLS TYP

1/4" free clearance - Drill H
8 PLS TYP

LAFAYETTE COLLEGE ENGINEERING DIVISION | | DWG.#: 1inSquareSupportOut_D1 REV:

PART #: 1inSquareSupportOut | 3 QTY: | DRAWN BY: jonesdm

TOLERANCE EXCEPT AS NOTED X/X .X .XX .XXX B1/32 B.02 B.01 B.005 | PART FILE: 1inSquareSupportOut.ipt | 0.17:1 SCALE: | Approved by:

1 in. square tubing MATERIAL: | DATE: 4/15/2016
