Alexanderallenbrown/MotionBase/CAD/MotionBaseCAD/Real Platform/Drawings/PDFs/Spacer.pdf

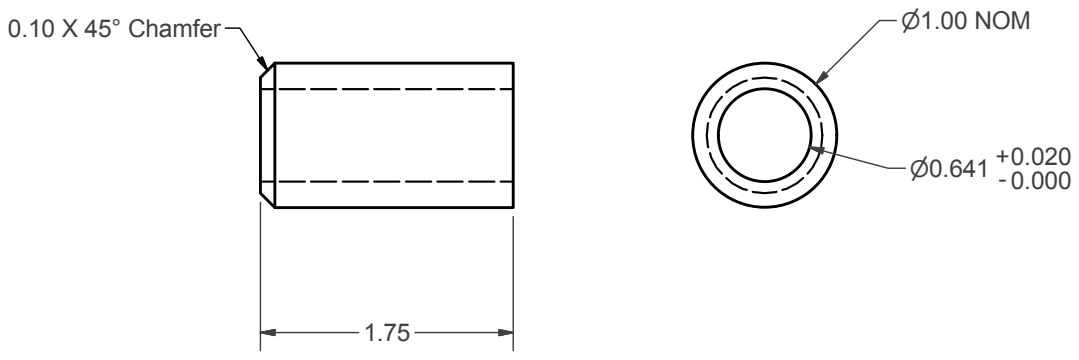
[picture p80: page 1]
P1.00 NOM; 0.10 X 45° Chamfer

LAFAYETTE COLLEGE ENGINEERING DIVISION | | DWG.#: Spacer_D1 REV:

PART #: Spacer | QTY: 1 | DRAWN BY: jonesdm

TOLERANCE EXCEPT AS NOTED X/X .X .XX .XXX B1/32 B.02 B.01 B.005 | PART FILE: Spacer.ipt | SCALE: 1:1 | Approved by:

1" Steel Round Stock MATERIAL: | DATE: 4/11/2016
