Alexanderallenbrown/MotionBase/CAD/MotionBaseCAD/Real Platform/Drawings/PDFs/ConRod.pdf

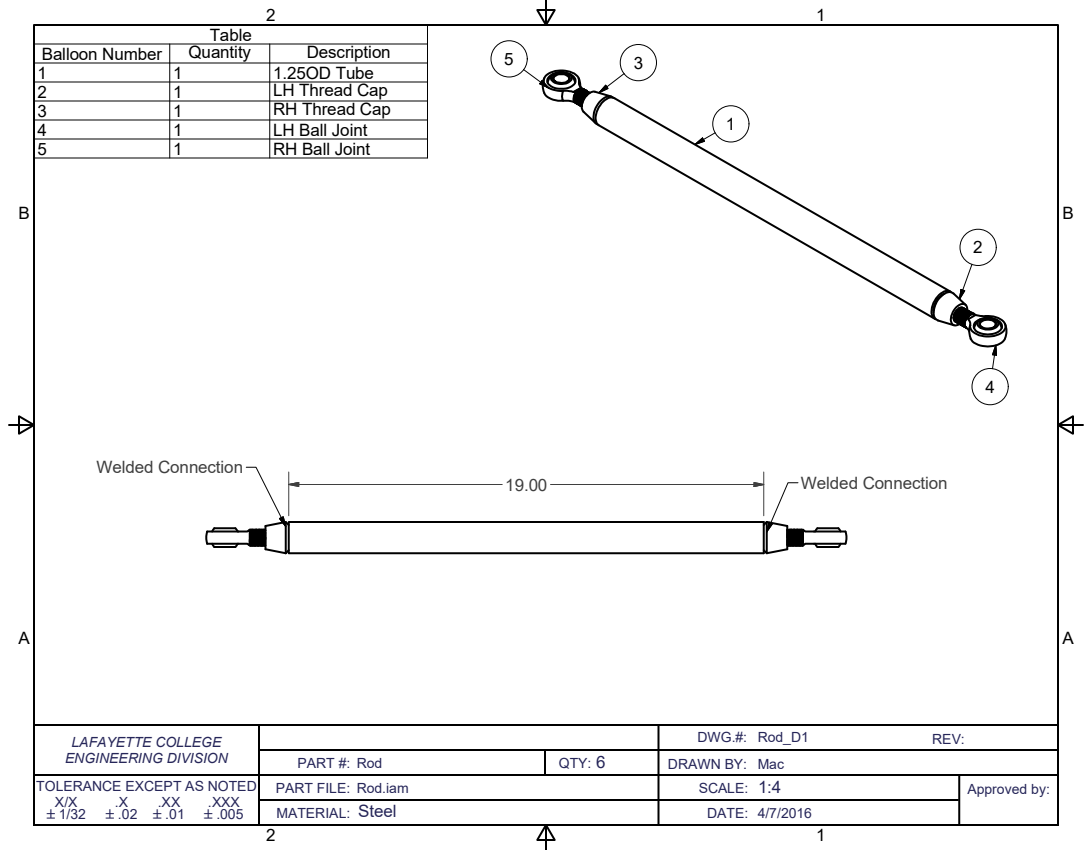
[picture p81: page 1]
Welded Connection; Table; Balloon Number; Quantity; Description; 1.25OD Tube; LH Thread Cap; RH Thread Cap; LH Ball Joint; RH Ball Joint

LAFAYETTE COLLEGE ENGINEERING DIVISION | | DWG.#: Rod_D1 REV:

PART #: Rod | 6 QTY: | DRAWN BY: Mac

TOLERANCE EXCEPT AS NOTED X/X .X .XX .XXX B1/32 B.02 B.01 B.005 | PART FILE: Rod.iam | 1:4 SCALE: | Approved by:

Steel MATERIAL: | DATE: 4/7/2016
