Alexanderallenbrown/MotionBase/CAD/MotionBaseCAD/Real Platform/Drawings/PDFs/Motor_Arm.pdf

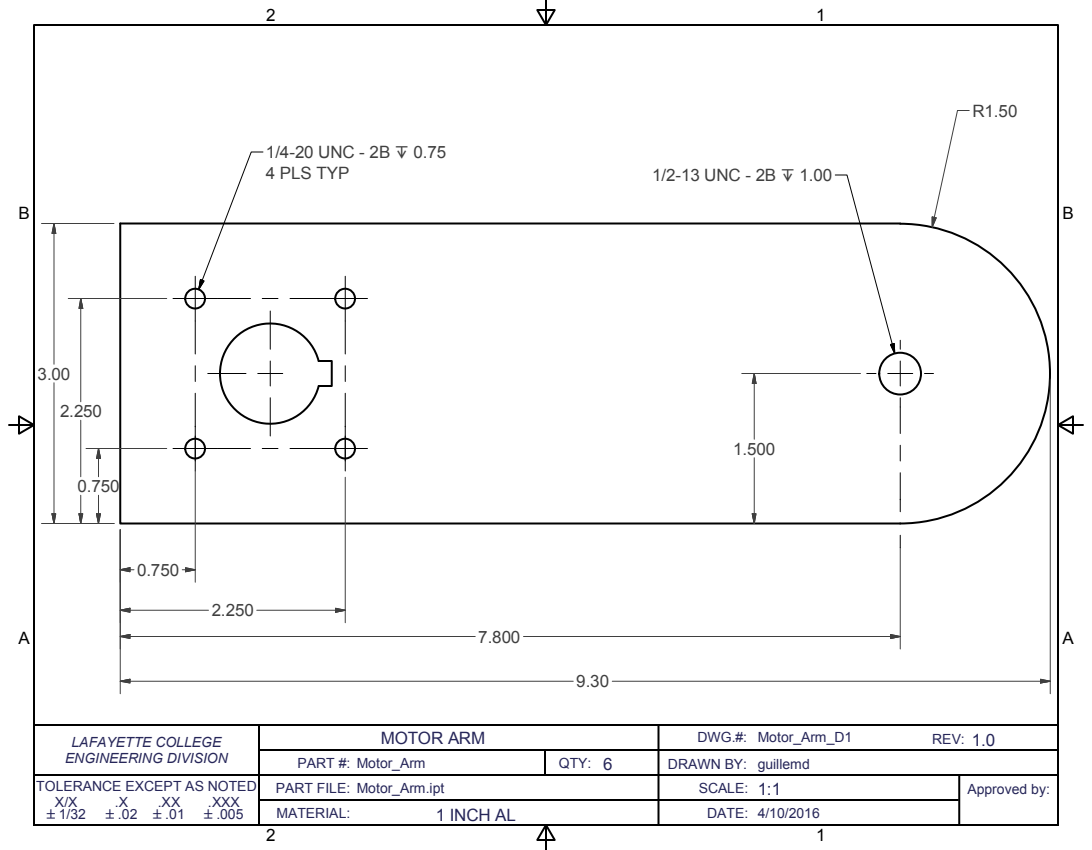
[picture p82: page 1]
1/2-13 UNC - 2B Z 1.00; 1/4-20 UNC - 2B Z 0.75; 4 PLS TYP

LAFAYETTE COLLEGE ENGINEERING DIVISION | MOTOR ARM | DWG.#: Motor_Arm_D1 REV: 1.0

PART #: Motor_Arm | QTY: 6 | DRAWN BY: guillemd

TOLERANCE EXCEPT AS NOTED X/X .X .XX .XXX B1/32 B.02 B.01 B.005 | PART FILE: Motor_Arm.ipt | SCALE: 1:1 | Approved by:

MATERIAL: 1 INCH AL | DATE: 4/10/2016
