Alexanderallenbrown/MotionBase/CAD/MotionBaseCAD/Real Platform/Drawings/PDFs/Top.pdf

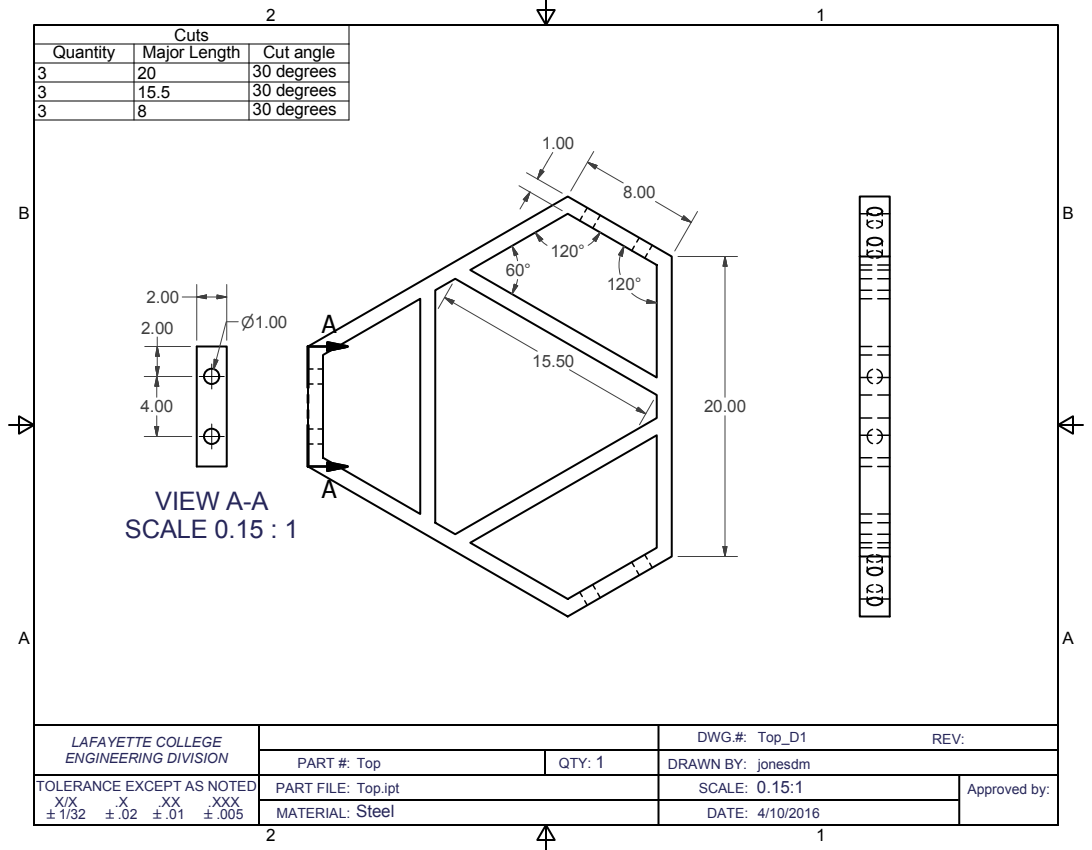
[picture p83: page 1]
VIEW A-A SCALE 0.15 : 1; Cuts; Quantity; Major Length; Cut angle; 30 degrees

LAFAYETTE COLLEGE ENGINEERING DIVISION | | DWG.#: Top_D1 REV:

PART #: Top | 1 QTY: | DRAWN BY: jonesdm

TOLERANCE EXCEPT AS NOTED X/X .X .XX .XXX B1/32 B.02 B.01 B.005 | PART FILE: Top.ipt | 0.15:1 SCALE: | Approved by:

Steel MATERIAL: | DATE: 4/10/2016
