Alexanderallenbrown/MotionBase/CAD/MotionBaseCAD/Real Platform/Drawings/PDFs/Top_attachment.pdf

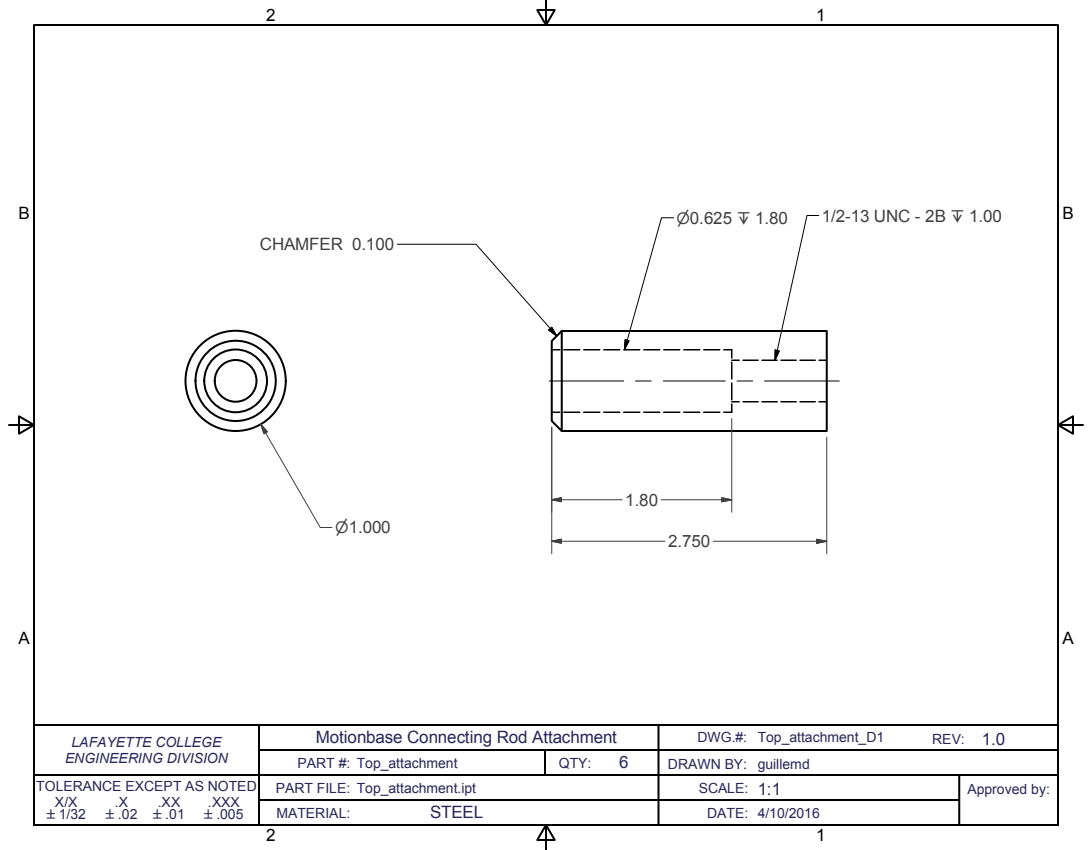
[picture p84: page 1]
CHAMFER 0.100; 1/2-13 UNC - 2B Z 1.00

LAFAYETTE COLLEGE ENGINEERING DIVISION | Motionbase Connecting Rod Attachment | 1.0 DWG.#: Top_attachment_D1 REV:

PART #: Top_attachment | 6 QTY: | DRAWN BY: guillemd

TOLERANCE EXCEPT AS NOTED X/X .X .XX .XXX B1/32 B.02 B.01 B.005 | PART FILE: Top_attachment.ipt | SCALE: 1:1 | Approved by:

STEEL MATERIAL: | DATE: 4/10/2016
