Alexanderallenbrown/MotionBase/CAD/MotionBaseCAD/Real Platform/Drawings/PDFs/Triangle End.pdf

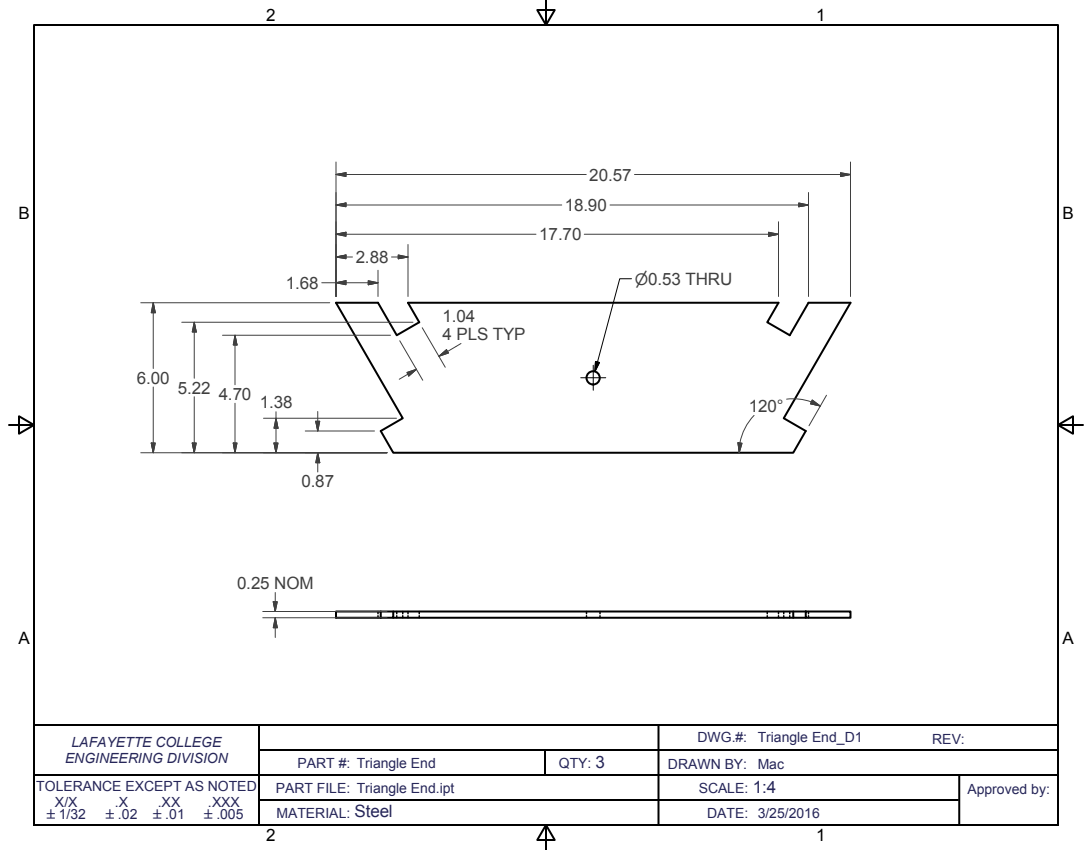
[picture p85: page 1]
0.25 NOM; P0.53 THRU; 1.04 4 PLS TYP

LAFAYETTE COLLEGE ENGINEERING DIVISION | | DWG.#: Triangle End_D1 REV:

PART #: Triangle End | 3 QTY: | DRAWN BY: Mac

TOLERANCE EXCEPT AS NOTED X/X .X .XX .XXX B1/32 B.02 B.01 B.005 | PART FILE: Triangle End.ipt | 1:4 SCALE: | Approved by:

Steel MATERIAL: | DATE: 3/25/2016
