Alexanderallenbrown/MotionBase/mini_platform/laser_files_final/all_parts.pdf

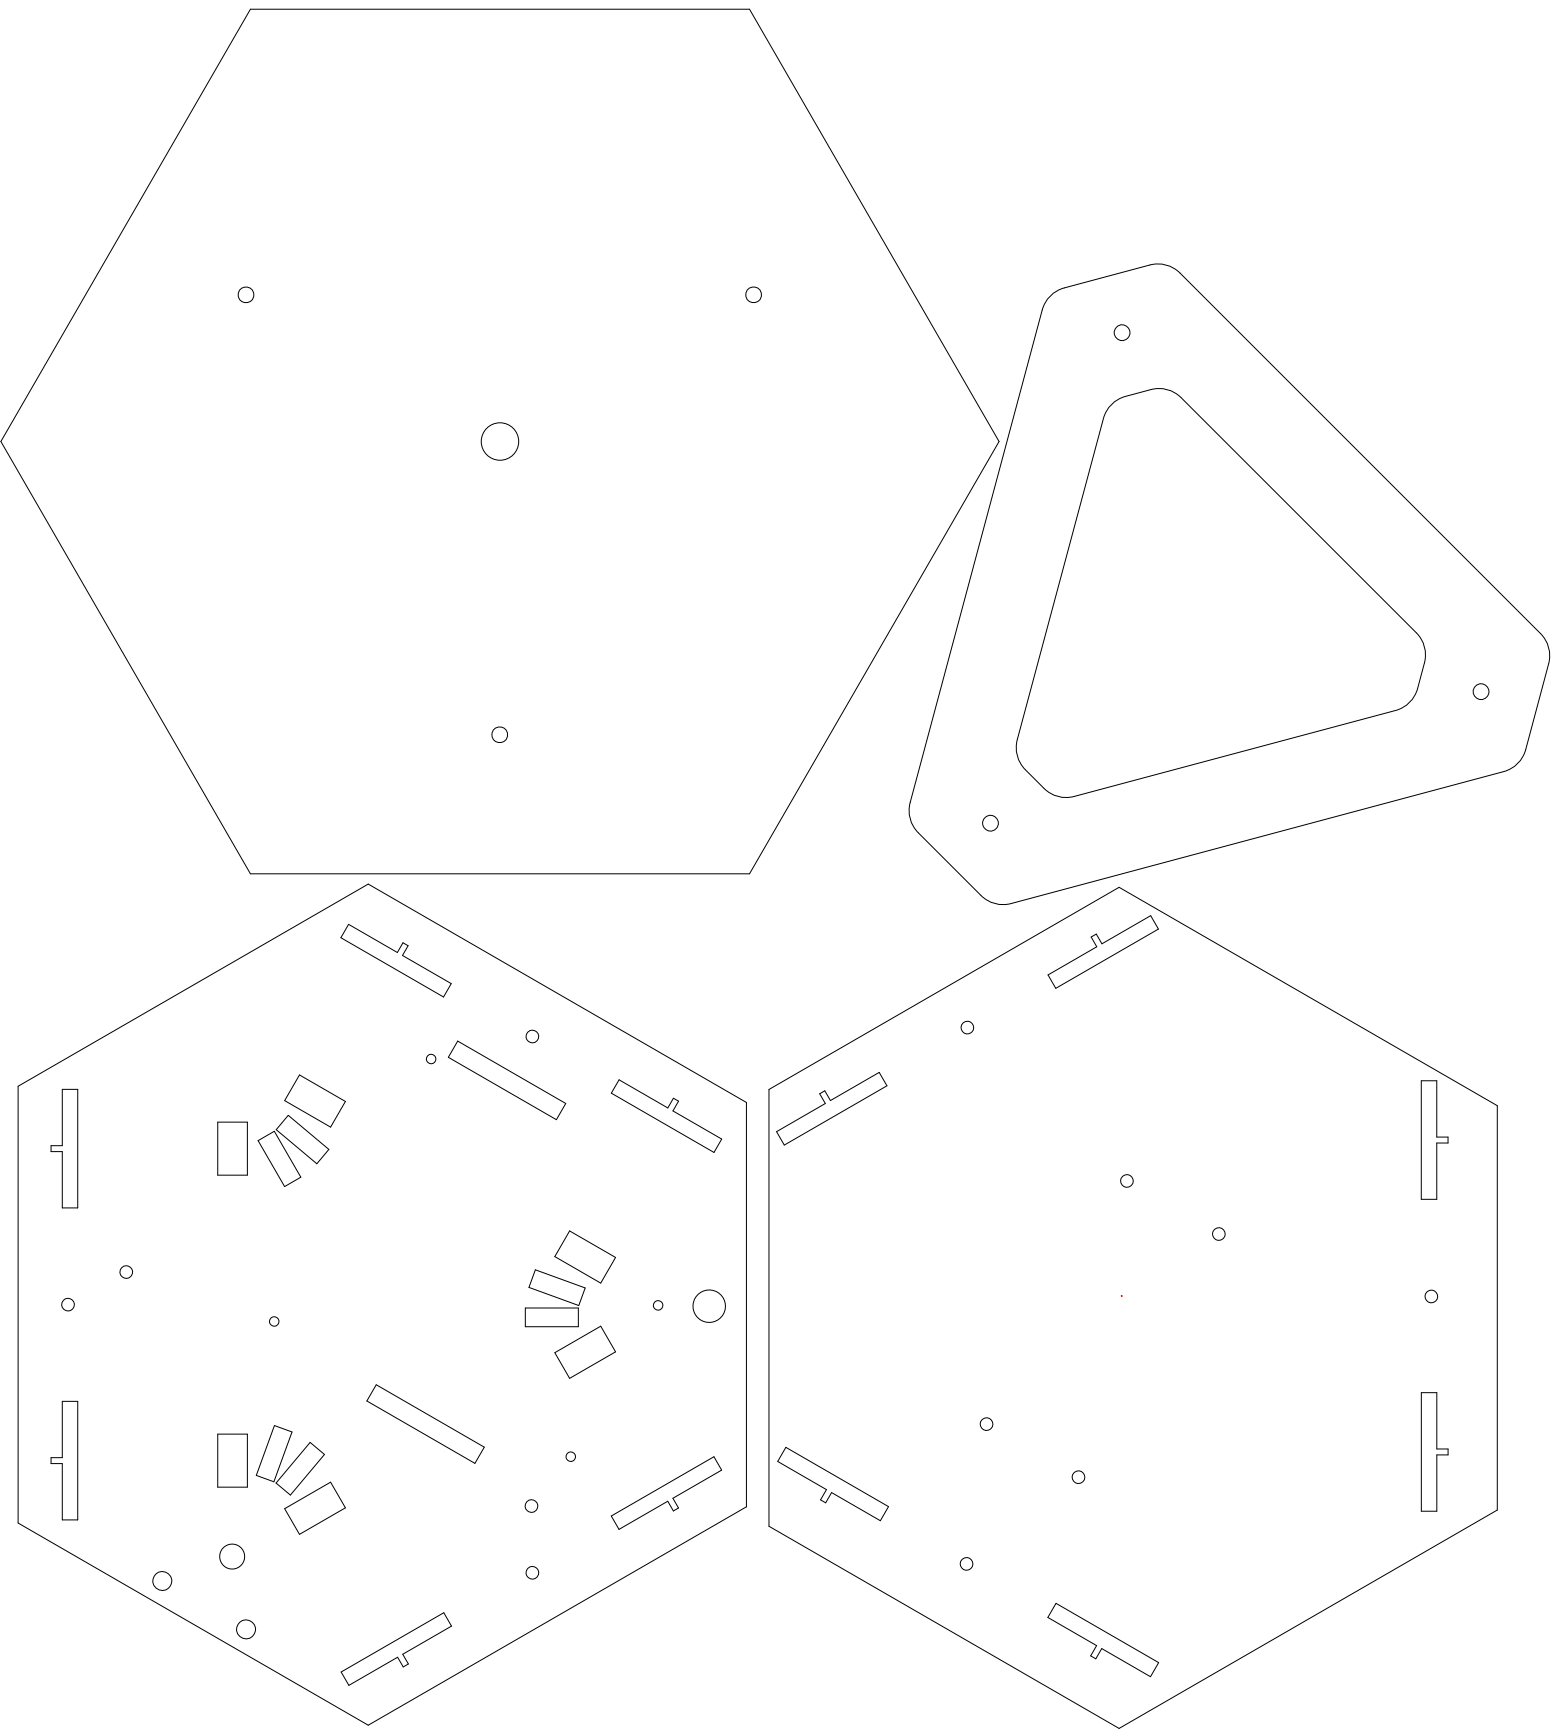
[picture p86: page 1]
