Alexanderallenbrown/MotionBase/mini_platform/laser_files_final/spare_arms.pdf

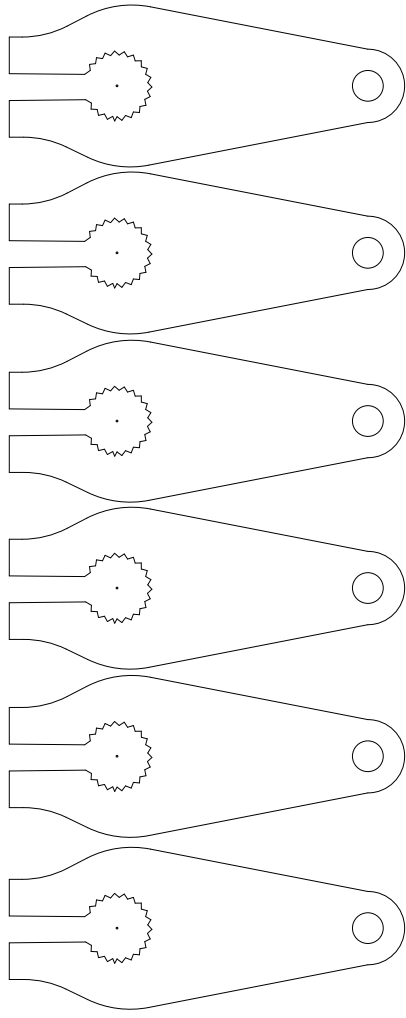
[picture p87: page 1]
