Alexanderallenbrown/MotionBase/CAD/MotionBaseCAD/arm.pdf

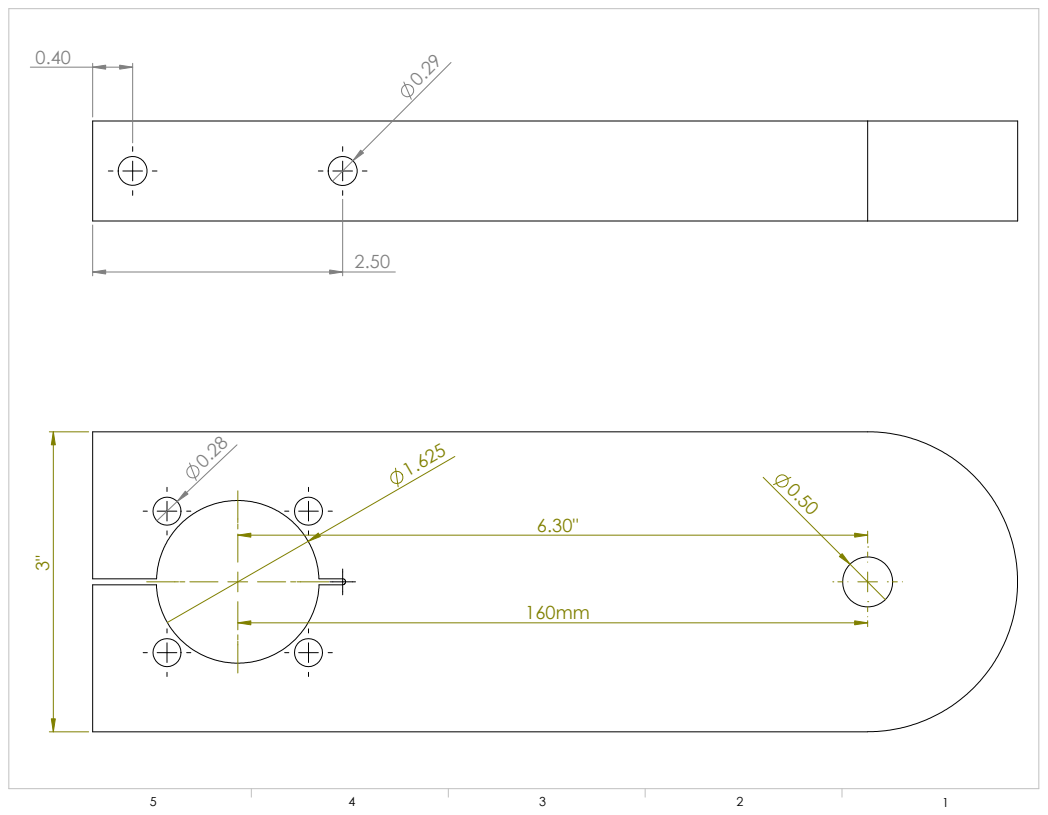
[picture p88: page 1]
