Alexanderallenbrown/MotionBase/CAD/MotionBaseCAD/gearbox.pdf

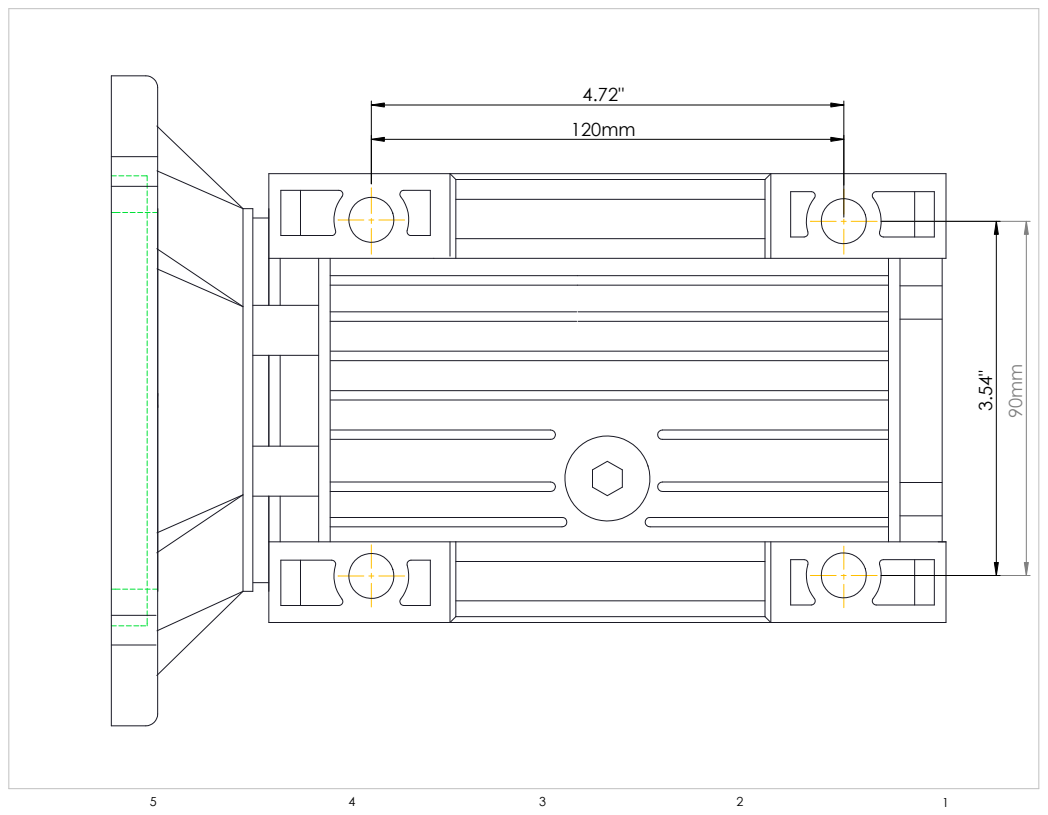
[picture p89: page 1]
