Alexanderallenbrown/MotionBase/mini_platform/python/speed_dreams_platform_thread.py

#!/usr/bin/env python
import socket
import sys, select
import time
from numpy import *
from scipy.signal import *
from matplotlib.pyplot import *
import sys,traceback
import serial
from threading import Thread


###### filtering function, at ~500 Hz
def filt():

  global t, ax_raw, ay_raw, az_raw, anglex_raw, angley_raw, anglez_raw, buffsize, anglezraw#, dt

  # initialize position variables
  N = 4
  x_desired = zeros(N)
  y_desired = zeros(N)
  z_desired = zeros(N)
  ax_tilt = zeros(N)
  ay_tilt = zeros(N)
  ax_raw_small = zeros(N)
  ay_raw_small = zeros(N)
  az_raw_small = zeros(N)
  anglex_raw_small = zeros(N)
  angley_raw_small = zeros(N)
  anglez_raw_small = zeros(N)
  anglex = 0
  angley = 0
  anglex_filtered=zeros(N)
  angley_filtered=zeros(N)
  anglez_filtered=zeros(N)
  anglez=zeros(N)
  ax_tiltLP=0
  ay_tiltLP=0
  index=0 
  command = [0,0,0,0,0,0]

  # initialize time variables
  starttime = time.time()
  oldtime = time.time()
  time.sleep(.01)
  # dt = 0.005
  lastsendtime = time.time()
  arduino_delay = 0.01
  lastfilttime = time.time()
  filter_delay = 0.05

  # Set up socket to send data
  ser = serial.Serial(
      port='/dev/ttyUSB100', #ACM100',   #USB0', 
      baudrate=115200) 
  print "initializing"
  ser.close()
  time.sleep(2.0)
  ser.open()
  time.sleep(2.0)
  print "done"  
  print len(t)
  while 1:        ## >>> 500 Hz
    
    tnow = time.time()  # what time is it mr. fox??
    #print tnow
    #print len(t)
    if len(t)>=buffsize:
      # timetime = time.time()
      # take most recent value read from buffer
      # trecent = time.time()
      ax_raw_small = append(ax_raw_small[1:],ax_raw[-1])
      ay_raw_small = append(ay_raw_small[1:],ax_raw[-1])
      az_raw_small = append(az_raw_small[1:],ax_raw[-1])
      anglex_raw_small = append(anglex_raw_small[1:],anglex_raw[-1])
      angley_raw_small = append(angley_raw_small[1:],angley_raw[-1])
      anglez_raw_small = append(anglez_raw_small[1:],anglez_raw[-1])
      
      # tapp = tnow-trecent
      # print tapp
      #print tnow-lastfilttime
      if (tnow-lastfilttime)>filter_delay:              ## filters run at ~500 Hz
        
        # tstartfilt = time.time()
        #determine time step
        # print dt[-1]
        dt = array([tnow-lastfilttime])
        #print dt
        lastfilttime = tnow #have to reset this!! otherwise we don't keep track of this properly.
        
        # oldtime = tnow

        #ay to y_desired, and ax to x_desired
        (num1,den1,dt1) = cont2discrete(([10,0],[1,10,20]),dt[-1])

        #ay to ax_tilt
        (num2,den2,dt2) = cont2discrete(([-32500.],[1,100,1300]),dt[-1])
  
        #anglex to anglex_filtered
        (num3,den3,dt3) = cont2discrete(([1,0],[1,2,4]),dt[-1])

        #az to z_desired
        (num4,den4,dt4) = cont2discrete(([10.,0],[1,11,110,100]),dt[-1])

        #anglez to anglez_filtered
        (num5,den5,dt5) = cont2discrete(([1,0,0],[1,2,4]),dt[-1])

        num1,num2,num3,num4,num5 = num1[0],num2[0],num3[0],num4[0],num5[0]

        x_desired = append(x_desired[1:],0)
        y_desired = append(y_desired[1:],0)
        z_desired = append(z_desired[1:],0)+0#####TODO!!!! THIS IS A TEMP

        anglez_filtered = append(anglez_filtered[1:],0)

        # timeendfilt = time.time()
        # filtTime=timeendfilt-tstartfilt
        # print filtTime
        # timetime = time.time()
        #final values: x_desired, y_desired, z_desired, anglex, angley, anglez
        if index>1:             ## happens way fast
          y_desired[3]=-den1[1]*y_desired[2]-den1[2]*y_desired[1]+num1[1]*ay_raw_small[2]+num1[2]*ay_raw_small[1]
          x_desired[3]=-den1[1]*x_desired[2]-den1[2]*x_desired[1]+num1[1]*ax_raw_small[2]+num1[2]*ax_raw_small[1]
          ax_tilt[3]=-den2[1]*ax_tilt[2]-den2[2]*ax_tilt[1]+num2[1]*ay_raw_small[2]+num2[2]*ay_raw_small[1]
          if abs(ax_tilt[3])>1.0:
            ax_tilt[3] = sign(ax_tilt[3])
          ax_tiltLP=math.asin(ax_tilt[3])
          ay_tilt[3]=-den2[1]*ay_tilt[2]-den2[2]*ay_tilt[1]+num2[1]*ax_raw_small[2]+num2[2]*ax_raw_small[1]
          if abs(ay_tilt[3])>1.0:
            ay_tilt[3] = sign(ax_tilt[3])
          ay_tiltLP=math.asin(-ay_tilt[3])

          anglex_filtered[3]=-den3[1]*anglex_filtered[2]-den3[2]*anglex_filtered[1]+num3[1]*anglex_raw_small[2]+num3[2]*anglex_raw_small[1]
          angley_filtered[3]=-den3[1]*angley_filtered[2]-den3[2]*angley_filtered[1]+num3[1]*angley_raw_small[2]+num3[2]*angley_raw_small[1]
          anglex=ax_tiltLP+anglex_filtered[3]
          angley=ay_tiltLP+angley_filtered[3]

          z_desired[3]=-den4[1]*z_desired[2]-den4[2]*z_desired[1]-den4[3]*z_desired[0]+num4[1]*az_raw_small[2]+num4[2]*az_raw_small[1]+num4[3]*az_raw_small[0]
          anglez_filtered[3]=-den5[1]*anglez_filtered[2]-den5[2]*anglez_filtered[1]+num5[0]*anglezraw+num5[1]*anglez_raw_small[2]+num5[2]*anglez_raw_small[1]
        else:
          y_desired[3]=0
          x_desired[3]=0
          z_desired[3]=0
          ay_tilt[3]=0 
          ax_tilt[3]=0 
          anglex=0
          angley=0
          anglex_filtered[3]=0
          angley_filtered[3]=0
          anglez_filtered[3]=anglezraw
        #how many times have we tried to filteR?
        index=index+1
        #what is our command?

        ##original
        #command = [x_desired[-1],y_desired[-1],z_desired[-1],ax_tiltLP,ay_tiltLP,anglez_filtered[-1]]

        ##attempt
        
        #set a soft limit for the angle commands...
        angle_softlim = 0.1

        xdes_final = 0#x_desired[-1]/100.0
        ydes_final = 0#y_desired[-1]/100.0
        zdes_final = 0#z_desired[-1]/100.0
        rdes_final = ax_tiltLP
        if abs(rdes_final)>angle_softlim:
          rdes_final = sign(rdes_final)*angle_softlim
        pdes_final = ay_tiltLP
        if abs(pdes_final)>angle_softlim:
          pdes_final = sign(pdes_final)*angle_softlim
        ades_final = anglez_filtered[-1]
        if abs(ades_final)>angle_softlim:
          ades_final = sign(ades_final)*angle_softlim
        #rdes_final = 0
        ades_final = 0 #TODO RELEASE THIS CONSTRAINT WHEN COMFORTABLE.
        command = [xdes_final,ydes_final,zdes_final,rdes_final,pdes_final,ades_final]

        #this worked before, but we just did some stuff above.
        #command = [x_desired[-1]/100.0,y_desired[-1]/100.0,(z_desired[-1]/100.0)+.5,ax_tiltLP,ay_tiltLP,anglez_filtered[-1]]

        # commandtime = time.time()
        # tcomm = commandtime - timetime
        # print tcomm
      #print "not frozen"
      if tnow-lastsendtime>arduino_delay:     ### also happens super fast
        #print 'sent'
        print "sent: "+format(command[0],'0.2f')+","+format(command[1],'0.2f')+","+format(command[2],'0.2f')+","+format(command[3],'0.4f')+","+format(command[4],'0.4f')+","+format(command[5],'0.4f')
        lastsendtime = tnow
        ser.write('!')
        for ind in range(0,len(command)-1):
          ser.write(format(command[ind],'0.2f'))
          ser.write(',')
        ser.write(str(command[-1]))
        ser.write('\n')
        #line = ser.readline()
        #print "recieved: "+line
    else:
      time.sleep(.1)
        
        # lasttime=time.time()
        # endend=lasttime-timetime
        # print endend


#this is a quick function to get rid of packets that have stacked up on us.
def FlushListen(sock):
  while 1:
    try:
      junkbytes=sock.recv(1024)
    except:
      break

      
########### function to read stuff from SpeedDreams and plot data
def getdata():    ### 1000 Hz (not including plot time)
  
  global t, ax_raw, ay_raw, az_raw, anglex_raw, angley_raw, anglez_raw, anglezraw, buffsize, dt

  # initialize stuff
  axraw = 0
  ayraw = 0
  azraw = 0
  anglexraw = 0
  angleyraw = 0
  anglezraw = 0
  ax_raw = []
  ay_raw = []
  az_raw = []
  anglex_raw = []
  angley_raw = []
  anglez_raw = []
  dt=[]
  # dt_mean = []

  # create UDP socket to receive data
  host = 'localhost' #does not have to be
  port = 8000 # some default
  send_address = (host, port) # Set the address to send to
  s = socket.socket(socket.AF_INET, socket.SOCK_DGRAM)    # Create Datagram Socket (UDP)
  s.setsockopt(socket.SOL_SOCKET, socket.SO_REUSEADDR, 1) # Make Socket Reusable
  s.setsockopt(socket.SOL_SOCKET, socket.SO_BROADCAST, 1) # Allow incoming broadcasts
  s.setblocking(False) # Set socket to non-blocking mode
  s.bind(('', port)) #Accept Connections on port
  print "Accepting connections on port", hex(port)
  

  # create a figure for us to see our data on
  ion()
  fig,ax = subplots(3,1)
  ax[0].hold(True)
  ax[1].hold(True)
  ax[2].hold(True)
  fig.canvas.draw()
  plt1 = ax[0].plot(0,0,'r')[0]
  plt2 = ax[1].plot(0,0,'k')[0]
  plt3 = ax[2].plot(0,0,'b')[0]
  buffsize = 500  #might want to change this
  t = []
  plotXvals = []
  plotYvals = []
  plotZvals = []
  plot_delay = 0.1 #seconds
  plotoldtime = time.time()

  # now loop through to get data
  while 1:
    # startarttime = time.time()
    starttime = time.time()

    #try flushing extra crap out of the socket
    FlushListen(s)
    time.sleep(.0005)

    try:              ## really fast, >>> 500 Hz
      # startmessage = time.time()
      message, address = s.recvfrom(8192) # Buffer size. Change as needed.  
      # endmessageTime = time.time()
      # msgTime = endmessageTime-startmessage
      # print msgTime
      
    except:
      message = None
      
    if message is not None:           ## 1000 Hz and faster
      #print "msg received"
      # startmessagesplit = time.time()
      message_split = message.split(',')            
      axraw = float(message_split[0])
      ayraw = float(message_split[1])
      azraw = float(message_split[2])
      anglexraw = float(message_split[3])
      angleyraw = float(message_split[4])
      anglezraw = float(message_split[5])
      ax_raw=append(ax_raw,axraw) 
      ay_raw=append(ay_raw,ayraw) 
      az_raw=append(az_raw,azraw) 
      anglex_raw=append(anglex_raw,anglexraw)  
      angley_raw=append(angley_raw,angleyraw)  
      anglez_raw=append(anglez_raw,anglezraw) 

      # endmessageSplitTime = time.time()
      # msgSplitTime = endmessageSplitTime-startmessagesplit
      # print msgSplitTime

      #calculate dt
      endtime = time.time()
      diff = endtime - starttime
      dt = append(dt,diff)
      # dt_mean = np.mean(dt[-20:-1])
      starttime = time.time()
      # print dt_mean
      
      # endtimetime= time.time()
      # endendtimetime = endtimetime-startarttime
      # print endendtimetime

      #for plotting
      if len(t)<buffsize:
        t.append(time.time()-starttime)
        plotXvals.append(axraw)
        plotYvals.append(ayraw)
        plotZvals.append(azraw)
      else: 
        t = t[1:]
        t.append(time.time())
        plotXvals = plotXvals[1:]
        plotXvals.append(axraw)
        plotYvals = plotYvals[1:]
        plotYvals.append(ayraw)
        plotZvals = plotZvals[1:]
        plotZvals.append(azraw)

      if (time.time()-plotoldtime>plot_delay and len(t)>=buffsize):#if enough time has passed
        #set the old time
        plotoldtime = time.time()
        #set our X limits of the plot to only look at the last 5 seconds of data
        ax[0].set_xlim(t[-1]-5,t[-1])
        ax[0].set_ylim(-1.3,1.3)
        ax[1].set_xlim(t[-1]-5,t[-1])
        ax[1].set_ylim(-1.3,1.3)
        ax[2].set_xlim(t[-1]-5,t[-1])
        ax[2].set_ylim(-1.3,1.3)
        #this sets the line plt1 data to be our updated t and r vectors.
        plt1.set_data(t,plotXvals)
        plt2.set_data(t,plotYvals)
        plt3.set_data(t,plotZvals)
        #the draw command is last, and tells matplotlib to update the figure!!
        fig.canvas.draw()
        pause(.0001)#must have a small pause here or nothing will work. Pause is a matplotlib.pyplot function.
      time.sleep(.0005)

    else:
      pass
      #time.sleep(.001)

      

  


####### execute the thread
if __name__ == "__main__" :

    thread1 = Thread(target=getdata,args=())
    thread2 = Thread(target=filt,args=())

    thread1.start()
    thread2.start()
    thread1.join()
    thread2.join()
   
    
