Alexanderallenbrown/MotionBase/(commit log)

2016-01-27 added roundabout data from Chevy Silverado
    [2012-03-17_17-44-36.csv, 2015-01-24_11-49-26.csv, chopped_2015-01-24_11-49-26.csv]
2016-02-03 Added first iteration of CAD model
    [24_inch_square.0001.ipt, 24_inch_square.ipt, 45degree_brace.ipt, 48_Inch_square.ipt, 60_inch_square.0001.ipt, 60_inch_square.ipt, DMJ_Head.ipt, DMJ_Legs.0002.ipt]
2016-02-05 Matlab Files from Andy's Simulation program
    [rawdata.csv]
2016-02-05 Andy's New Files
    [rawdata.csv]
2016-02-08 Updated Simulink and matlab
    [rawdata.csv, rawdata.xlsx]
2016-02-10 Updated Matlab, but not working yet
    [rawdata.csv, rawdata.xlsx]
2016-02-11 Updated Matlab with torque-omega curve
2016-02-11 Updated Matlab with new filters
2016-02-15 Fixed direction of short leg 4 in hii.m
2016-02-16 Created a different branch (Maybe?) for high pass filters
2016-02-17 fixed the legs
2016-02-17 Added initial models with arms and triangular platform
    [BasePlatform.0001.ipt, BasePlatform.ipt, MotionBaseGeneric.0009.iam, MotionBaseGeneric.iam, Motor.ipt, Platform.0001.ipt, Platform.ipt, Rod.ipt]
2016-02-18 added plot script for data
    [2015-01-24_11-49-26.csv]
2016-02-18 some fixes to the roundabout plotting
    [2015-01-24_11-49-26.csv]
2016-02-18 more edits to Andy's code
    [2015-01-24_11-49-26.csv]
2016-02-22 New Model of Motion Base
    [BasePlatform.0001.ipt, BasePlatform.0002.ipt, BasePlatform.ipt, Bearing.ipt, MotionBaseGeneric.0009.iam, MotionBaseGeneric.0014.iam, MotionBaseGeneric.iam, Platform.0002.ipt]
2016-02-22 Updated CAD. Added premade motors for design purpose.
    [BasePlatform.0003.ipt, BasePlatform.0004.ipt, BasePlatform.ipt, Front Rail.0001.ipt, Front Rail.ipt, MotionBaseGeneric.0014.iam, MotionBaseGeneric.0019.iam, MotionBaseGeneric.iam]
2016-02-22 fixed plot issue on one of the ipython notebooks.
    [motionbasefunctions.py]
2016-02-24 Updated CAD with new motor, gearbox, and added joints.
    [00 - Pedalier CSP V2.iam, Bearing.0002.ipt, Bearing.ipt, GearShaft.0001.ipt, GearShaft.ipt, MotionBaseGeneric.0019.iam, MotionBaseGeneric.0029.iam, MotionBaseGeneric.iam]
2016-02-24 Updated functional CAD. No Screens or wheel.
    [00 - Pedalier CSP V2.iam, GearShaft.0001.ipt, GearShaft.0002.ipt, GearShaft.ipt, MotionBaseGeneric.0029.iam, MotionBaseGeneric.0034.iam, MotionBaseGeneric.iam, Platform.0001.ipt]
2016-03-02 Not much change if any at all
    [MotionBaseGeneric.0034.iam, MotionBaseGeneric.0035.iam, MotionBaseGeneric.iam, RailSlide.STEP]
2016-03-04 had moved folder out of directory (oops), moved it back
    [2015-01-24_11-49-26.csv, rawdata.csv, rawdata.xlsx]
2016-03-04 I have gone through all of Andy's code hii.m, have added comments and loops to make the code easier to understand. Tried not to change the method too much, but the torque curve looks off so there mus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
2016-03-05 not much change
    [rawdata.csv, rawdata.xlsx]
2016-03-07 fixes to coordinate system @alexanderallenbrown
    [2015-01-24_11-49-26.csv]
2016-03-09 turned desired motion into desired velocity and acceleration to send to platform
2016-03-09 almost done with torque code, just need to switch to angle bisection method, also added a nice plot to the figures folder
2016-03-09 added high pass filter to simulation but sampling is giving errors
2016-03-10 fixed yaw rollover
2016-03-14 finished switching to bisection method, started changing motor yaws
2016-03-20 added mini platform folder with board design, arduino code, and python code.
    [base_bot.dxf, base_top.dxf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]
2016-03-22 Updated CAD files with TV mount and new geometry
    [1inSquareSupport.ipt, 1inSquareSupport2.0002.ipt, 1inSquareSupport2.ipt, 1inSquareSupportOut.0002.ipt, 1inSquareSupportOut.ipt, Chair Support Side.ipt, Chair.0001.iam, Chair.iam]
2016-03-22 Update CAD with new color scheme
    [Chair.0001.iam, Chair.0002.iam, Chair.iam, MotionBaseFixed.0002.iam, MotionBaseFixed.0005.iam, MotionBaseFixed.iam, Motor Shim.ipt, MotorRail.0005.iam]
2016-03-22 I don't remember doing anything new, but you never know. All CAD stuff, though
    [MotionBaseFixed.0005.iam, MotionBaseFixed.0006.iam, MotionBaseFixed.iam, MotorRail.0008.iam, MotorRail.0009.iam, MotorRail.iam, Top.0007.iam, Top.0008.iam]
2016-03-22 One last save as well as rendered images of the platform
    [Chair.0002.iam, Chair.0003.iam, Chair.iam, GearShaft.0003.ipt, GearShaft.0005.ipt, GearShaft.ipt, MotionBaseFixed.0006.iam, MotionBaseFixed.0008.iam]
2016-03-25 Arduino code for motor control
2016-03-25 updated arduino for motor control
2016-03-25 Updated CAD. Added drawing of triangle corner. Added Bill of Materials
    [00 - Pedalier CSP V2.0001.iam, 00 - Pedalier CSP V2.iam, Base Platform.xlsx, MotionBaseFixed-referenceDimensions.idw, MotionBaseFixed.0008.iam, MotionBaseFixed.0009.iam, MotionBaseFixed.iam, MotionBaseGeneric.0043.iam]
2016-03-28 added laser cutter templates for mini base
    [base_bot.dxf, base_top.dxf, platform_bot.dxf, platform_top.dxf, servo_arm.dxf]
2016-03-28 Updating CAD
    [1inSquareSupport2.0002.ipt, 1inSquareSupport2.0003.ipt, 1inSquareSupport2.ipt, MotionBaseFixed.0009.iam, MotionBaseFixed.0010.iam, MotionBaseFixed.iam, MotionBaseGeneric.0044.iam, MotionBaseGeneric.0045.iam]
2016-04-04 updates on python for mini platform filtering
2016-04-04 Added ConRod BOM
    [ConRods.xlsx]
2016-04-04 Updated ConRod BOM
    [ConRods.xlsx]
2016-04-07 added ConRod Drawing for manufacture
    [BallJoint.ipt, ConRod.0001.idw, ConRod.idw, ConRods.xlsx, MotionBaseFixed.0010.iam, MotionBaseFixed.0011.iam, MotionBaseFixed.iam, Rod.0001.ipt]
2016-04-09 Added files via upload
    some filters
2016-04-10 Part drawings, etc.
    [Motor_Arm.0001.idw, Motor_Arm.0002.ipt, Motor_Arm.dwg, Motor_Arm.dxf, Motor_Arm.idw, Motor_Arm.ipt, Motor_Shaft_Attachment.ipt, Top_attachment.idw]
2016-04-10 Updated Drawings. Added PDFs. Added Top and Bottom Triangle BOM
    [Base Platform.xlsx, BaseTriangle.xlsx, ConRods.xlsx, MotionBaseFixed.0011.iam, MotionBaseFixed.0012.iam, MotionBaseFixed.iam, Top.0002.ipt, Top.idw]
2016-04-11 Part drawings and Motionbase flow diagram
    [Motor_Shaft_Attachment.0001.idw, Motor_Shaft_Attachment.dwg, Motor_Shaft_Attachment.dxf, Motor_Shaft_Attachment.idw]
2016-04-11 Updated drawings. Updated Base BOM
    [1inSquareSupport2.0003.ipt, 1inSquareSupport2.0005.ipt, 1inSquareSupport2.ipt, BaseTriangle.iam, BaseTriangle.xlsx, MotionBaseFixed.0012.iam, MotionBaseFixed.0013.iam, MotionBaseFixed.iam]
2016-04-11 Added spacer drawing for base
    [MotionBaseFixed.0013.iam, MotionBaseFixed.0014.iam, MotionBaseFixed.iam, MotorRail.0017.iam, MotorRail.0018.iam, MotorRail.iam, Spacer.0001.ipt, Spacer.0002.idw]
2016-04-11 added connection holes to motor base
    [MotionBaseFixed.0011.iam, MotionBaseFixed.0012.iam, MotionBaseFixed.iam, Motor4.0001.ipt, Motor4.0005.ipt, Motor4.ipt, Motor5.0005.ipt, Motor5.ipt]
2016-04-13 designing boxes to hold eStop buttons
    [back.ipt, bottom.ipt, eStopBox.0001.iam, eStopBox.iam, sideL.ipt, sideR.0001.ipt, sideR.ipt, top.0001.ipt]
2016-04-13 added holes and fillets
    [back.0002.ipt, back.ipt, bottom.0002.ipt, bottom.ipt, eStopBox.0001.iam, eStopBox.0003.iam, eStopBox.iam, sideL.0001.ipt]
2016-04-14 Added digikey BOM
    [Digikey.xlsx]
2016-04-15 updated motorail
    [1inSquareSupport2.0005.ipt, 1inSquareSupport2.0006.ipt, 1inSquareSupport2.ipt, Motor4.0005.ipt, Motor4.0006.ipt, Motor4.ipt, MotorRailSpaced.0001.iam, MotorRailSpaced.0002.iam]
2016-04-15 motor shim work
    [Motor Shim.0001.ipt, Motor Shim.ipt]
2016-04-15 added drawings for square tube
    [1inSquareSupport2.0006.ipt, 1inSquareSupport2.0007.ipt, 1inSquareSupport2.idw, 1inSquareSupport2.ipt, 1inSquareSupportOut.0002.ipt, 1inSquareSupportOut.0003.ipt, 1inSquareSupportOut.idw, 1inSquareSupportOut.ipt]
2016-04-15 Updated square tube drawings
    [1inSquareSupport2.0002.idw, 1inSquareSupport2.idw, 1inSquareSupportOut.0001.idw, 1inSquareSupportOut.idw]
2016-04-18 ready for laser cutter
    [eStopLaserCut.idw]
2016-04-18 Added Sparkfun BOM for Arduinos
    [Mouser-Arduinos.xlsx]
2016-04-18 changed Mouser to Sparkfun in BOM filename
    [Sparkfun-Arduinos.xlsx]
2016-04-18 fixed communication issue in Arduino. Still wrestling with a little bit of delay.
    [platform_simple.ino, speed_dreams_platform.py]
2016-04-18 quickened arduino update rate. still a bit of lag. filters need tuninggit add .
2016-04-19 updated filters to match demostration1 simulink
2016-04-20 threaded python code for mini-platform, still more sleuthing to be done for the delay
2016-04-21 fixed dt issue, checked times of loops, delay still at ~1.5 sec
    [speed_dreams_platform_plot.py, speed_dreams_platform_thread.py]
2016-04-21 added socket flush lever to platform code. Called at each loop to dump extra packets we don't need (that are old). Seems to keep things snappy.
    [speed_dreams_platform_thread.py]
2016-04-23 Purchase Requests added
    [Digikey_4-23.xlsx, McMaster_4-23.xlsx, Motor Shim.0001.ipt, Motor Shim.0002.ipt, Motor Shim.ipt]
2016-04-25 changed arduino code to use PWM
2016-04-25 added software flowchart for wiki
2016-04-29 fixes to software flowchart
    [discrete_tf_example.py]
2016-05-03 adding a vector of zero positions for the motors in the p position control arduino code
2016-05-03 added zeros to encoder_P_position arduino file for each motor. need to copy into encoder_P_position2 when the time is right.
2016-05-04 arduino code changes
2016-05-04 arduino stuff
2016-05-05 added yaw GIF for wiki
2016-05-06 fixed dimensions and motor yaws
    [platform_simple_fullsize_thisone.ino, platform_test.py, speed_dreams_platform_thread.py]
2016-05-12 I think I fixed the delay problem when running SpeedDreams, issue was on Arduino side
    [platform_simple_fullsize_thisone.ino, platform_test.py, speed_dreams_platform_thread.py]
2016-05-12 major change to arduino code
2016-05-16 trying to fix freezing problem, seems to be when using Mega
    [platform_simple.ino, platform_simple_fullsize_thisone.ino, speed_dreams_platform_thread_experiments.py]
2016-05-30 Added half of the motor covers into 'CAD/MotionBaseGeneric.iam'
    [00 - Pedalier CSP V2.0001.iam, 00 - Pedalier CSP V2.0002.iam, 00 - Pedalier CSP V2.iam, 1inSquareSupport2.0007.ipt, 1inSquareSupport2.0008.ipt, 1inSquareSupport2.ipt, 1inSquareSupportOut.0003.ipt, 1inSquareSupportOut.0004.ipt]
2016-05-31 added all motor covers (.ipt and .iam) to directory, added all covers to 'MotionBaseGeneric.iam'
    [InsideWall.0002.ipt, InsideWall.ipt, LeftMotorCover.0001.iam, LeftMotorCover.0002.iam, LeftMotorCover.iam, MotionBaseGeneric.0046.iam, MotionBaseGeneric.0047.iam, MotionBaseGeneric.iam]
2016-06-01 added new arduino file with new platform attachment points. not tested yet.
2016-06-07 changes to arduino
2016-06-14 Updated arduino
2016-06-15 Added Base Skirt Assembly
    [1inSquareSupport2.0008.ipt, 1inSquareSupport2.0009.ipt, 1inSquareSupport2.ipt, Assembly1.iam, FullSkirt.0002.iam, FullSkirt.iam, LargeHorizBeam.0001.ipt, LargeHorizBeam.ipt]
2016-06-23 Controller Mount
    [2ndVert.0002.ipt, 2ndVert.ipt, ControllerMount.0001.iam, ControllerMount.iam, FrontHoriz.0001.ipt, FrontHoriz.ipt, FullSkirt.0002.iam, FullSkirt.0003.iam]
2016-07-19 New Arduino code for encoders
2016-07-19 controller mount sharp cap
    [FrontHorizTop.ipt, SharpCap.ipt]
2016-07-19 sharp cap
    [ControllerMount.0003.iam, ControllerMount.0004.iam, ControllerMount.iam, FrontHoriz.0002.ipt, FrontHoriz.0003.ipt, FrontHoriz.ipt, FrontHorizTop.0001.ipt, FrontHorizTop.ipt]
2016-07-21 E-Stop Button Cover
    [buttonInchPipeMount.0001.ipt, buttonInchPipeMount.ipt, buttonInchPipeMount.stl]
2016-07-25 button mount
2016-08-09 Added OSVR Blender files
    [books.blend, car_joy_cam.blend, car_joy_cam_new.blend, chairs.blend, coatStand.blend, desks.blend, dustBin.blend, lamps.blend]
2016-08-10 Car Road Stuff
    [car_joy_cam_new.blend]
