Alexanderallenbrown/MotionBase/(notices)

Notices in the files:
platform_arduino_code/platform_NEWANGLES/platform_NEWANGLES.ino:
the Free Software Foundation, either version 3 of the License, or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
